braingram/stompy/docs/engine.md

Toyota land cruiser 2F engine (likely 1984:

https://en.wikipedia.org/wiki/Toyota_F_engine#2F

https://drive.google.com/drive/u/0/folders/0B5A2uNJ5ku1vfjJteHVhTnlReDZTcnRqa2hSbVFxMk9rVmVxb3V1NjZkLVpBU0FJSk9jbTg

Converted to propane

(quoted specs)
135 hp
200 ft-lb torque

stompy carb (throttle body and mixer) look a lot like this:
https://www.ebay.com/itm/Propane-LPG-Forklift-Carburetor-Carb-Mixer-CA125-20-M-CA125-20M/112722418038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

impco ca125 knock off?

http://propanedepot.ca/wp-content/uploads/2012/09/IMPCO-Model-CA125-Caburetor.pdf
