braingram/stompy/stompy/simulation/data/full_meshes/calf_lower.stl

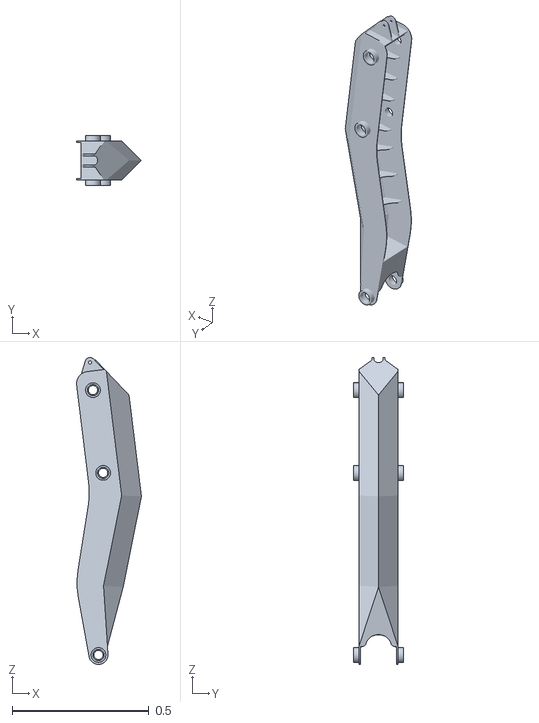
[picture p1: CAD file, 2019-08-05]
stompy/simulation/data/full_meshes/calf_lower.stl
0.237 x 0.181 x 1.12
