braingram/stompy/stompy/simulation/data/low_poly_meshes/hip.stl

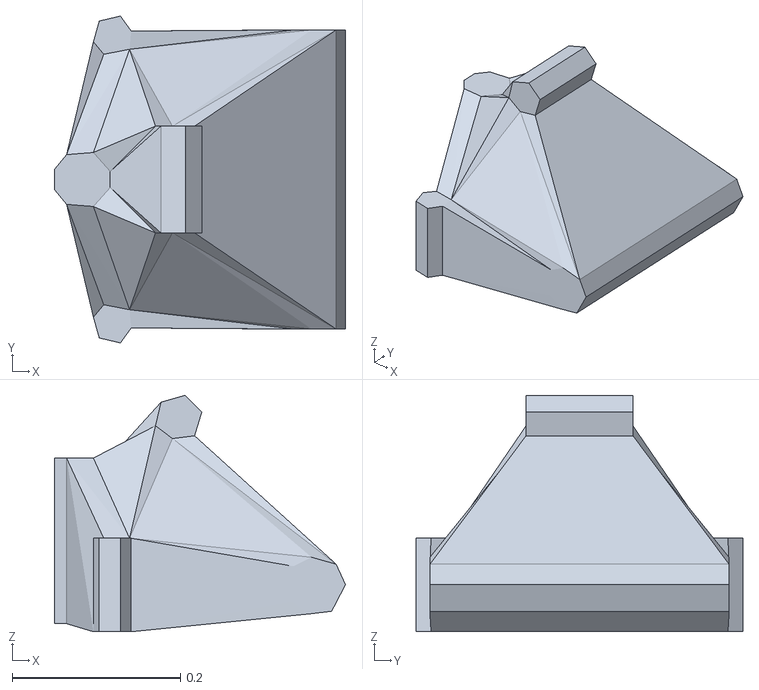
[picture p2: CAD file, 2019-08-05]
stompy/simulation/data/low_poly_meshes/hip.stl
0.346 x 0.389 x 0.281
