braingram/stompy/stompy/simulation/data/plane.obj

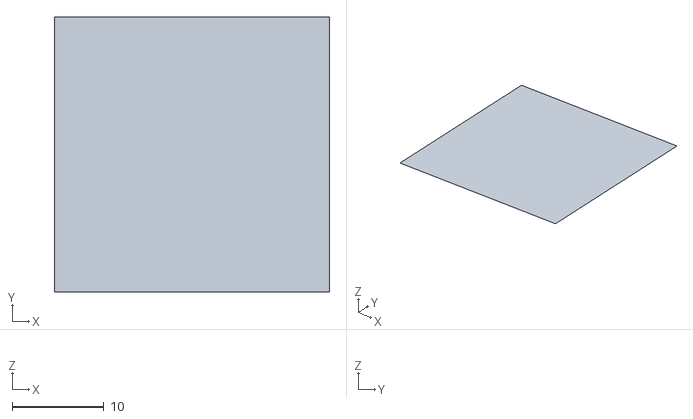
[picture p3: CAD file, 2019-08-05]
stompy/simulation/data/plane.obj
30.0 x 30.0 x 0
