braingram/stompy/stompy/simulation/data/full_meshes/thigh.stl

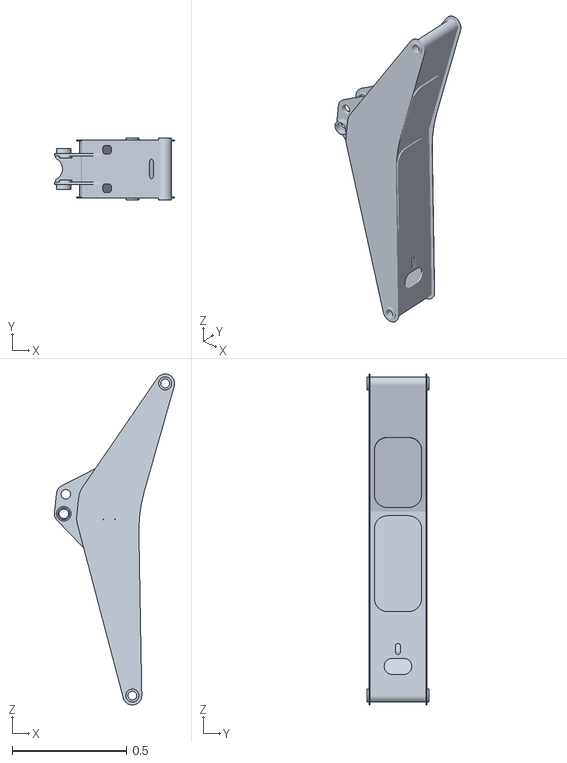
[picture p4: CAD file, 2019-08-05]
stompy/simulation/data/full_meshes/thigh.stl
0.525 x 0.273 x 1.45
