braingram/stompy/stompy/simulation/data/low_poly_meshes/calf_lower.stl

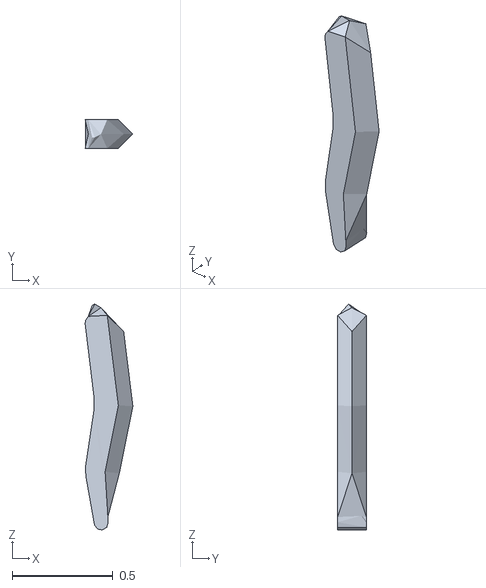
[picture p5: CAD file, 2019-08-05]
stompy/simulation/data/low_poly_meshes/calf_lower.stl
0.237 x 0.143 x 1.12
