braingram/stompy/stompy/simulation/data/full_meshes/hip.stl

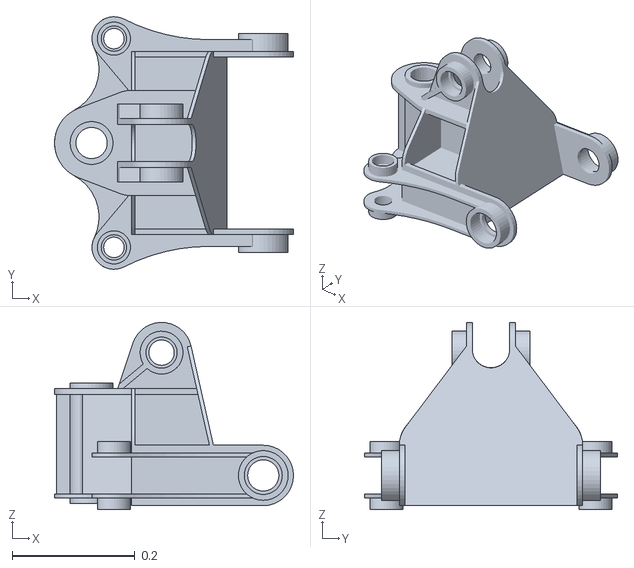
[picture p6: CAD file, 2019-08-05]
stompy/simulation/data/full_meshes/hip.stl
0.389 x 0.411 x 0.305
