braingram/stompy/stompy/simulation/data/low_poly_meshes/ankle.stl

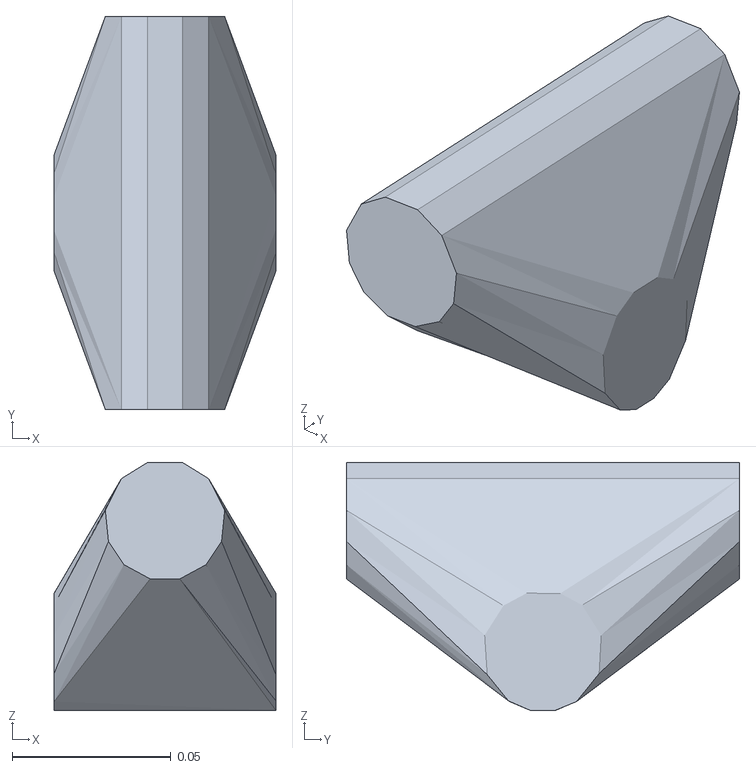
[picture p7: CAD file, 2019-08-05]
stompy/simulation/data/low_poly_meshes/ankle.stl
0.0698 x 0.124 x 0.0781
