braingram/stompy/stompy/simulation/data/full_meshes/calf_upper.stl

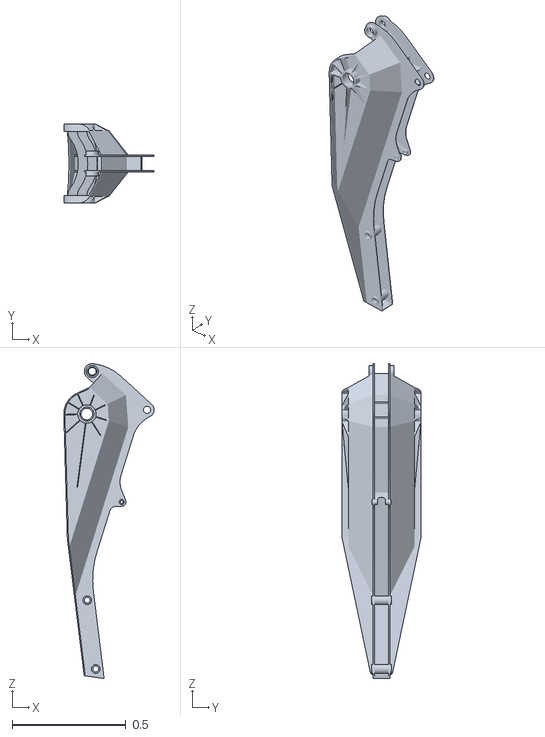
[picture p8: CAD file, 2019-08-05]
stompy/simulation/data/full_meshes/calf_upper.stl
0.398 x 0.346 x 1.39
