braingram/stompy/stompy/simulation/data/low_poly_meshes/calf_upper.stl

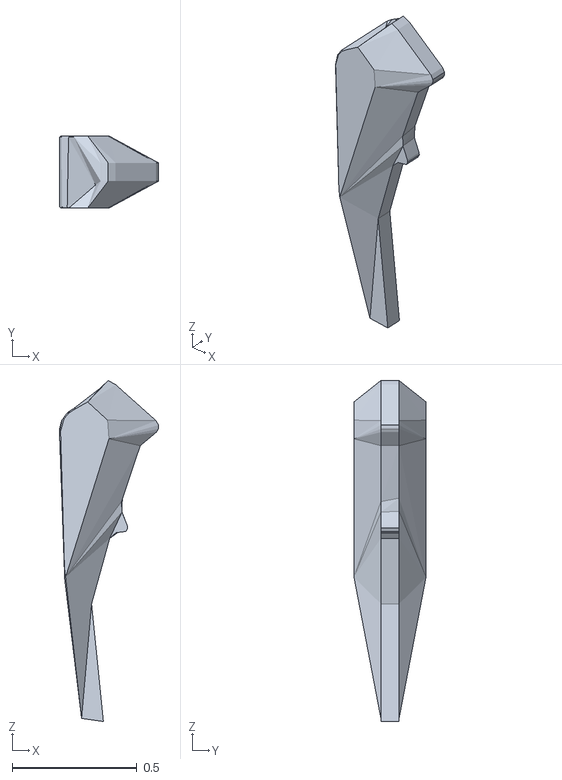
[picture p9: CAD file, 2019-08-05]
stompy/simulation/data/low_poly_meshes/calf_upper.stl
0.397 x 0.289 x 1.37
