braingram/stompy/stompy/simulation/data/full_meshes/body.stl

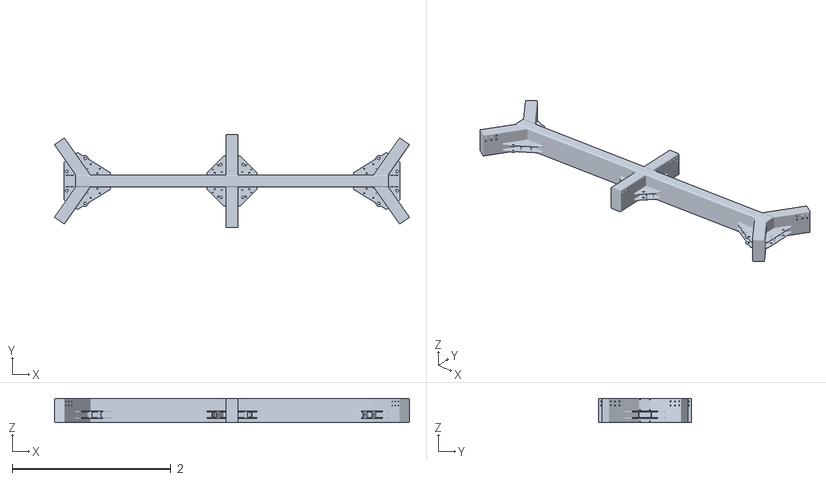
[picture p10: CAD file, 2018-02-03]
stompy/simulation/data/full_meshes/body.stl
4.48 x 1.17 x 0.305
