braingram/stompy/stompy/simulation/data/low_poly_meshes/foot.stl

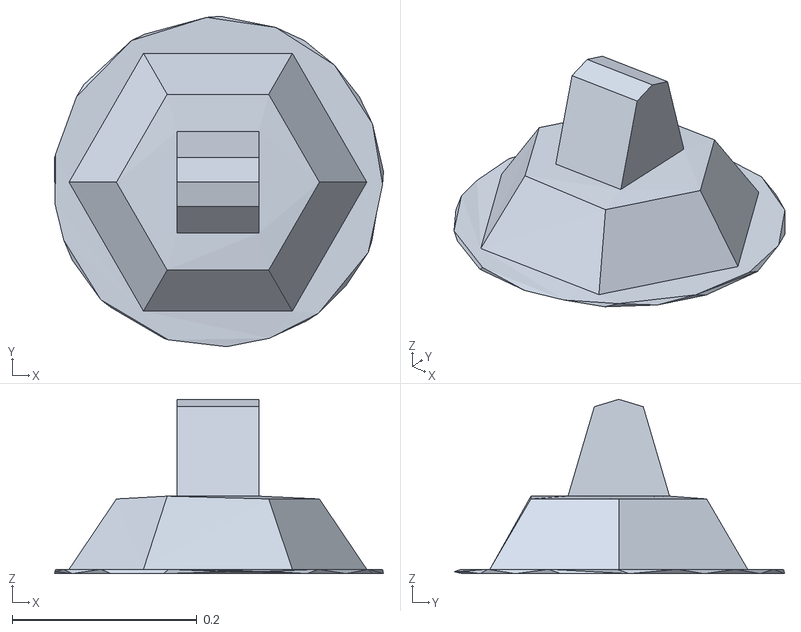
[picture p11: CAD file, 2019-08-05]
stompy/simulation/data/low_poly_meshes/foot.stl
0.356 x 0.358 x 0.189
