braingram/stompy/stompy/simulation/data/full_meshes/calf_link.stl

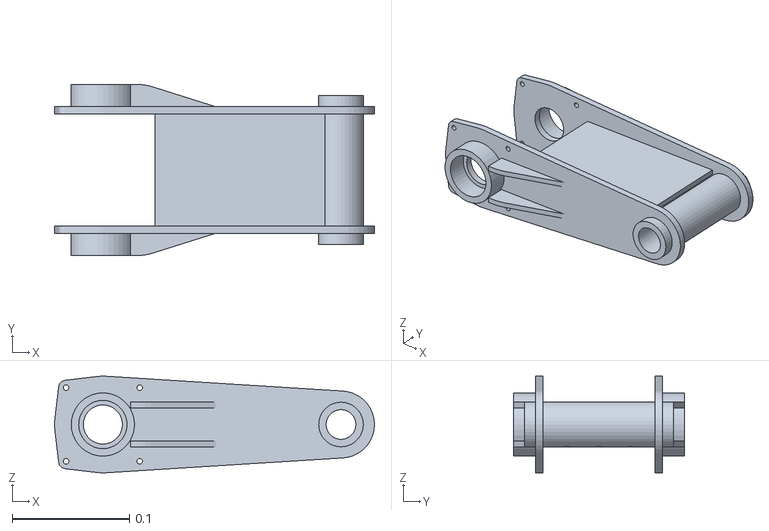
[picture p12: CAD file, 2018-02-03]
stompy/simulation/data/full_meshes/calf_link.stl
0.273 x 0.146 x 0.0825
