braingram/stompy/stompy/simulation/data/low_poly_meshes/body.stl

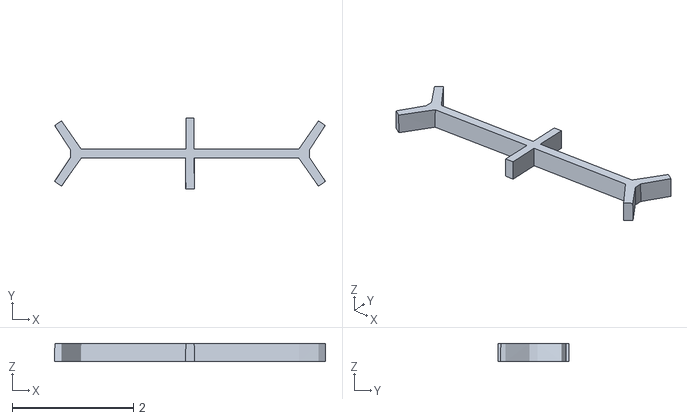
[picture p13: CAD file, 2019-08-05]
stompy/simulation/data/low_poly_meshes/body.stl
4.47 x 1.17 x 0.305
