braingram/stompy/stompy/simulation/data/full_meshes/ankle.stl

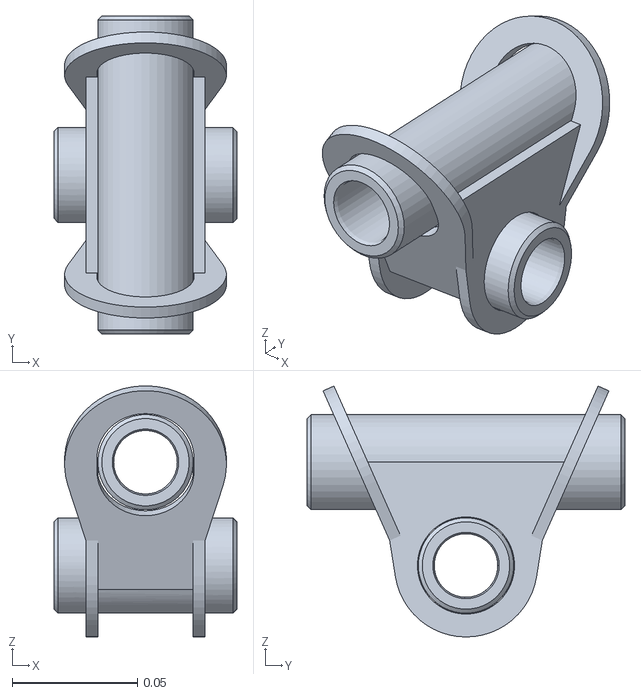
[picture p14: CAD file, 2018-02-03]
stompy/simulation/data/full_meshes/ankle.stl
0.073 x 0.127 x 0.1
