braingram/stompy/stompy/simulation/data/low_poly_meshes/calf_link.stl

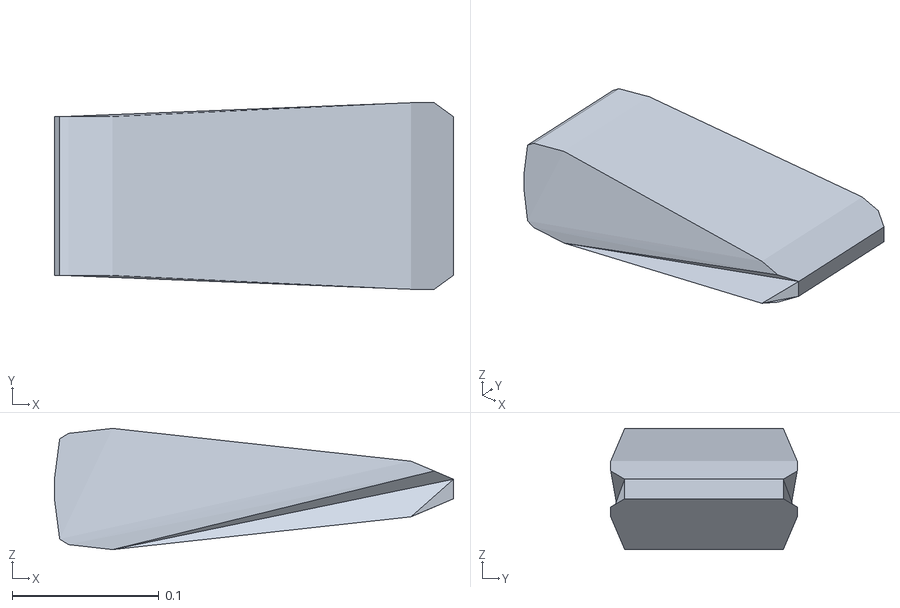
[picture p15: CAD file, 2019-08-05]
stompy/simulation/data/low_poly_meshes/calf_link.stl
0.272 x 0.127 x 0.0825
