braingram/stompy/stompy/simulation/data/full_meshes/foot.stl

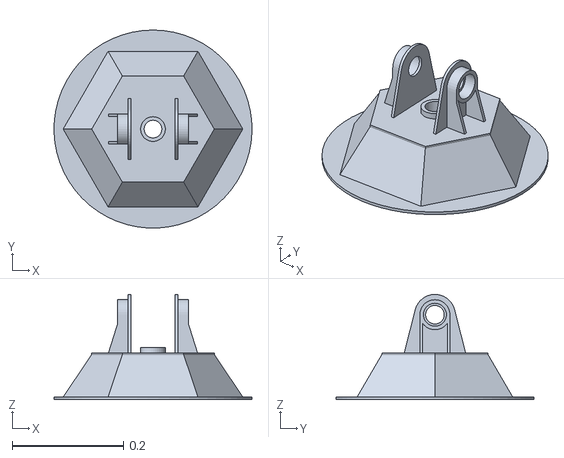
[picture p16: CAD file, 2018-02-03]
stompy/simulation/data/full_meshes/foot.stl
0.355 x 0.355 x 0.189
