braingram/stompy/stompy/simulation/data/low_poly_meshes/thigh.stl

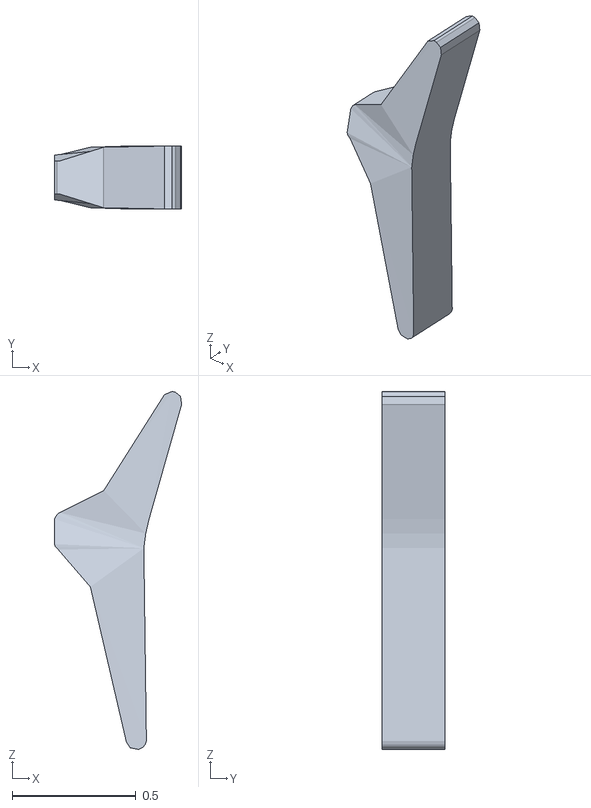
[picture p17: CAD file, 2019-08-05]
stompy/simulation/data/low_poly_meshes/thigh.stl
0.514 x 0.254 x 1.45
