braingram/stompy/(threads)

Thread 6 (2016-08-13):

Update sensors.joints.update_joints to allow for multiple joint publishers

braingram, 2016-08-13:
Each leg node will be publishing a different set of joints. These will come into the head node with different message headers. Keeping track of the arrival times could be useful.

Closed 2016-08-14.

Thread 7 (2016-08-13):

kinematics.leg.inverse deal with -x and x close to 0 errors

braingram, 2016-08-13:
