braingram/stompy/docs/cad_drawings/body_and_hips.pdf

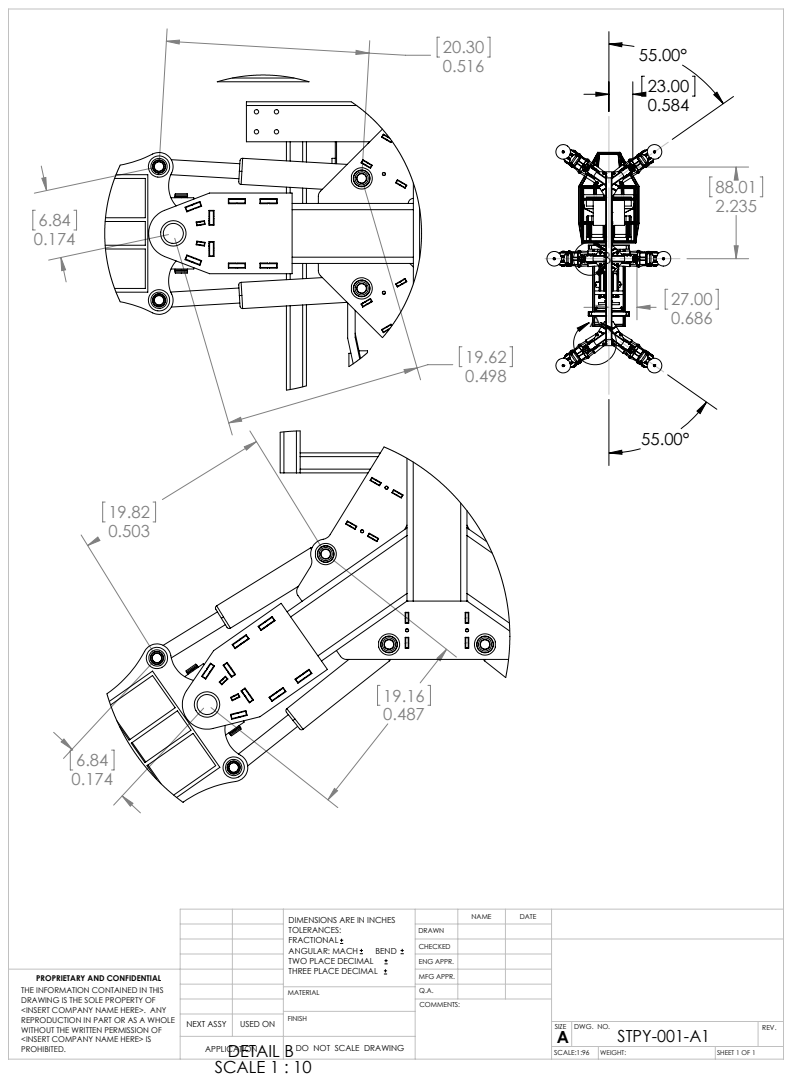
[picture p18: page 1]
SCALE 1 : 10

TOLERANCES: FRACTIONAL ANGULAR: MACH BEND TWO PLACE DECIMAL THREE PLACE DECIMAL | | NAME | DATE DIMENSIONS ARE IN INCHES

DRAWN
CHECKED
ENG APPR.

PROPRIETARY AND CONFIDENTIAL THE INFORMATION CONTAINED IN THIS DRAWING IS THE SOLE PROPERTY OF <INSERT COMPANY NAME HERE>. ANY REPRODUCTION IN PART OR AS A WHOLE WITHOUT THE WRITTEN PERMISSION OF <INSERT COMPANY NAME HERE> IS PROHIBITED. | | | MFG APPR.

MATERIAL | Q.A.

NEXT ASSY | USED ON | FINISH
DETAIL B APPLICATION | | DO NOT SCALE DRAWING

SIZE A | DWG. NO. STPY-001-A1 | REV.

SCALE:1:96 | WEIGHT: | SHEET 1 OF 1
