braingram/stompy/docs/cad_drawings/leg.pdf

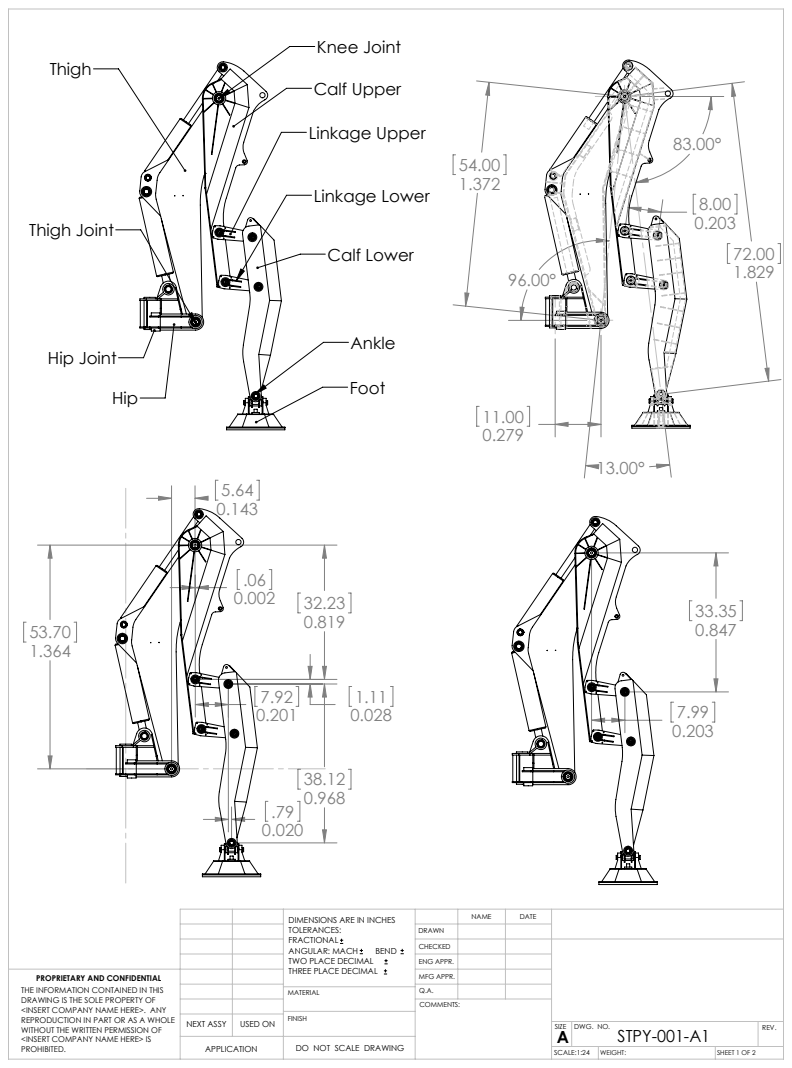
[picture p19: page 1]
Knee Joint; Calf Upper; Linkage Upper; Linkage Lower; Calf Lower; Thigh Joint; Hip Joint

TOLERANCES: FRACTIONAL ANGULAR: MACH BEND TWO PLACE DECIMAL THREE PLACE DECIMAL | | NAME | DATE DIMENSIONS ARE IN INCHES

DRAWN
CHECKED
ENG APPR.

PROPRIETARY AND CONFIDENTIAL THE INFORMATION CONTAINED IN THIS DRAWING IS THE SOLE PROPERTY OF <INSERT COMPANY NAME HERE>. ANY REPRODUCTION IN PART OR AS A WHOLE WITHOUT THE WRITTEN PERMISSION OF <INSERT COMPANY NAME HERE> IS PROHIBITED. | | | MFG APPR.

MATERIAL | Q.A.

NEXT ASSY | USED ON | FINISH

SIZE A | DWG. NO. STPY-001-A1 | REV.

APPLICATION | | DO NOT SCALE DRAWING

SCALE:1:24 | WEIGHT: | SHEET 1 OF 2

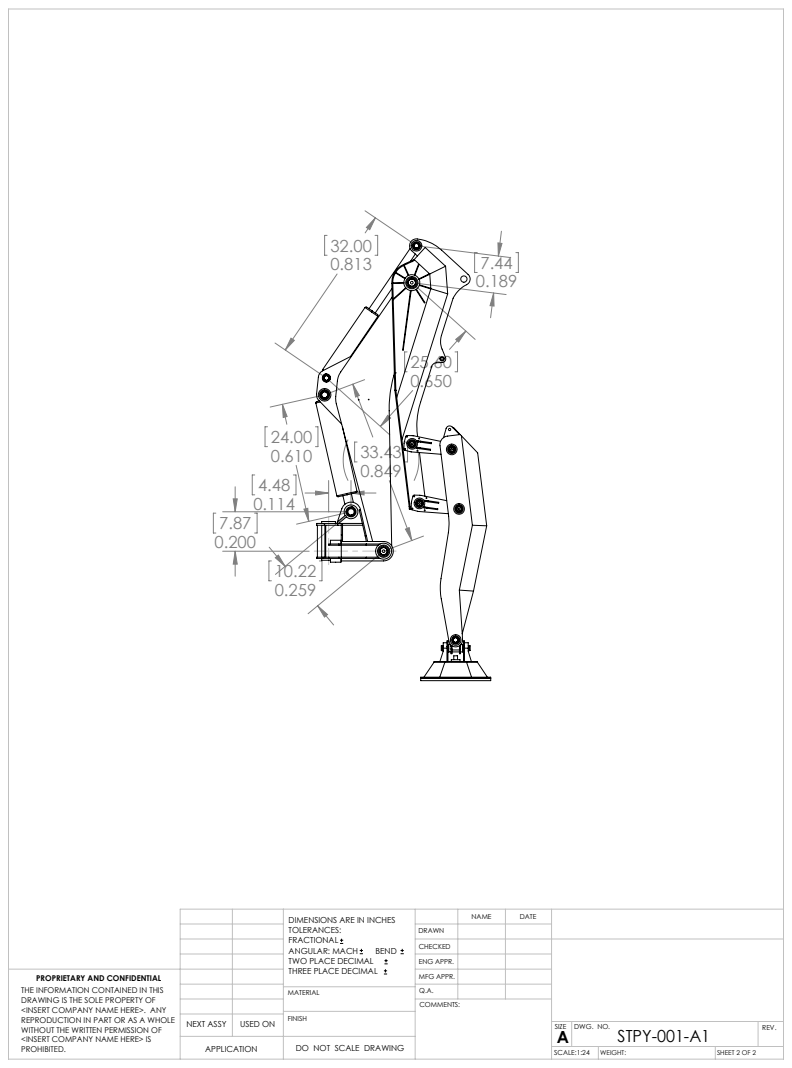
[picture p20: page 2]
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

DRAWN
CHECKED
ENG APPR.

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

MATERIAL | Q.A.

NEXT ASSY | USED ON | FINISH

SIZE A | DWG. NO. STPY-001-A1 | REV.

APPLICATION | | DO NOT SCALE DRAWING

SCALE:1:24 | WEIGHT: | SHEET 2 OF 2
