braingram/stompy/electronics/leg_thing/180513v1/leg_thing_pcb.pdf

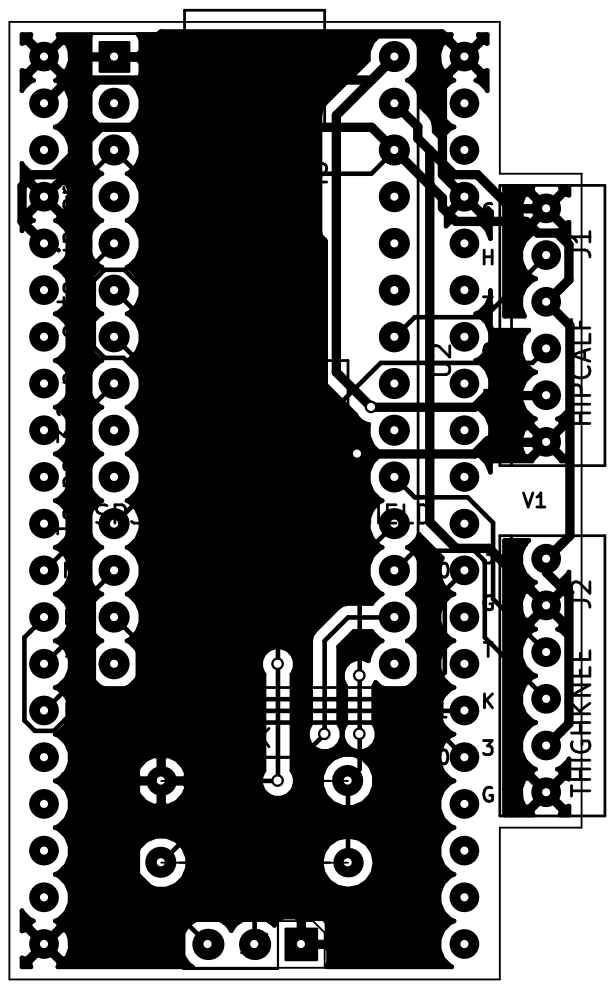
[picture p21: page 1]
