braingram/stompy/electronics/leg_thing/180513v1/leg_thing_sch.pdf

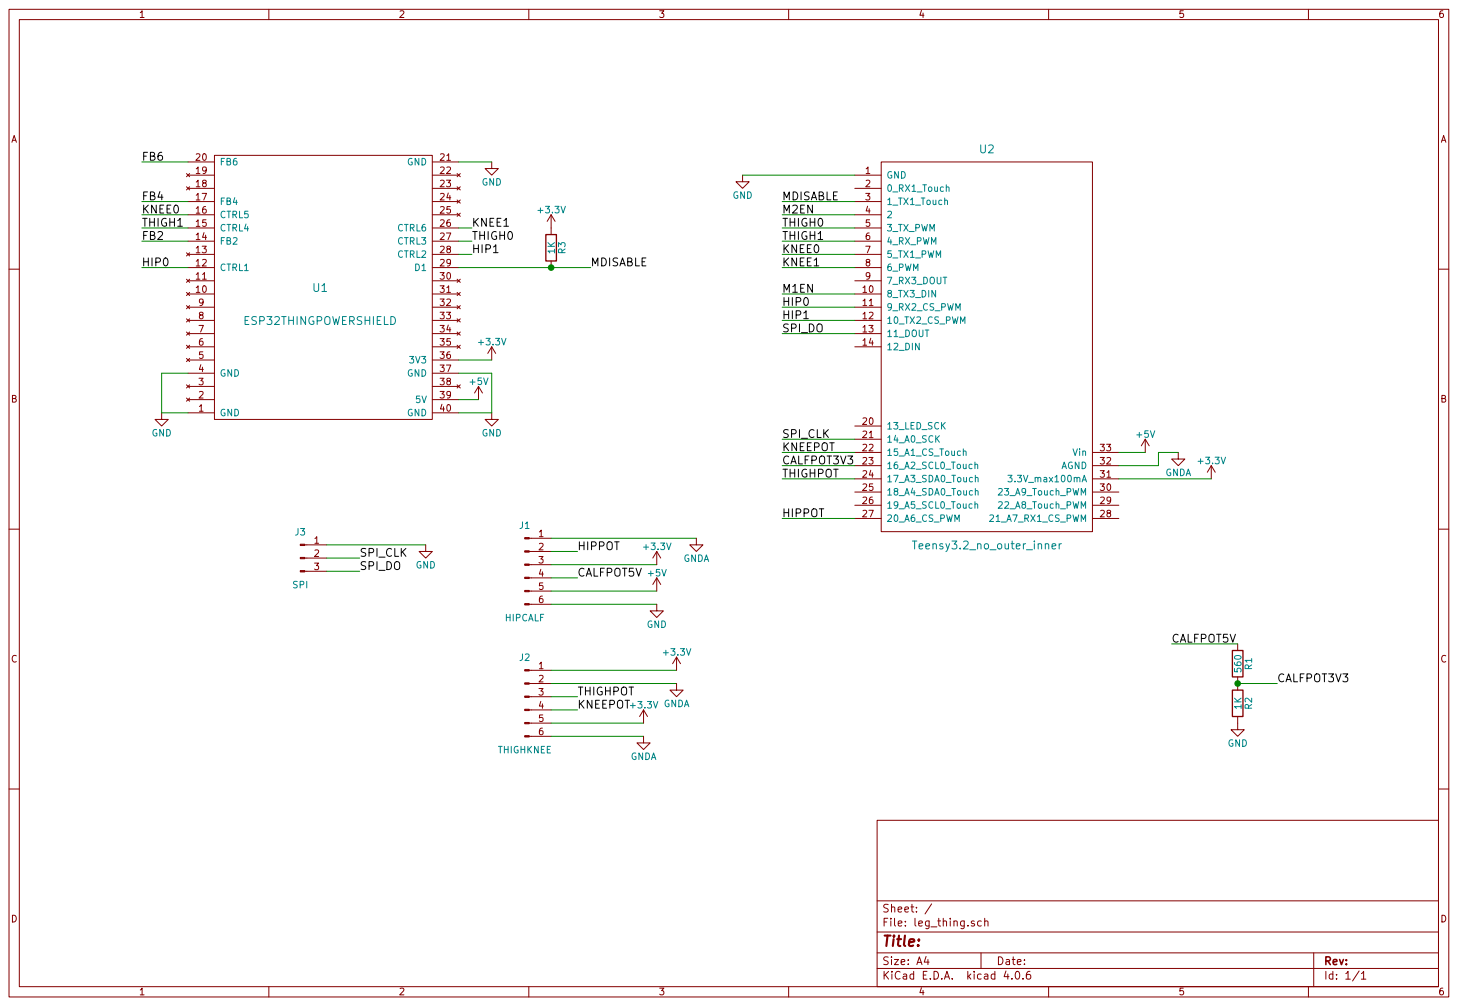
[picture p22: page 1]

THIGH0 | 3_TX_PWM 5

4_RX_PWM 6
