braingram/stompy/electronics/leg_thing/180513v1/leg_thing.kicad_pcb

## KiCad design electronics/leg_thing/180513v1/leg_thing.kicad_pcb (2018-05-27)

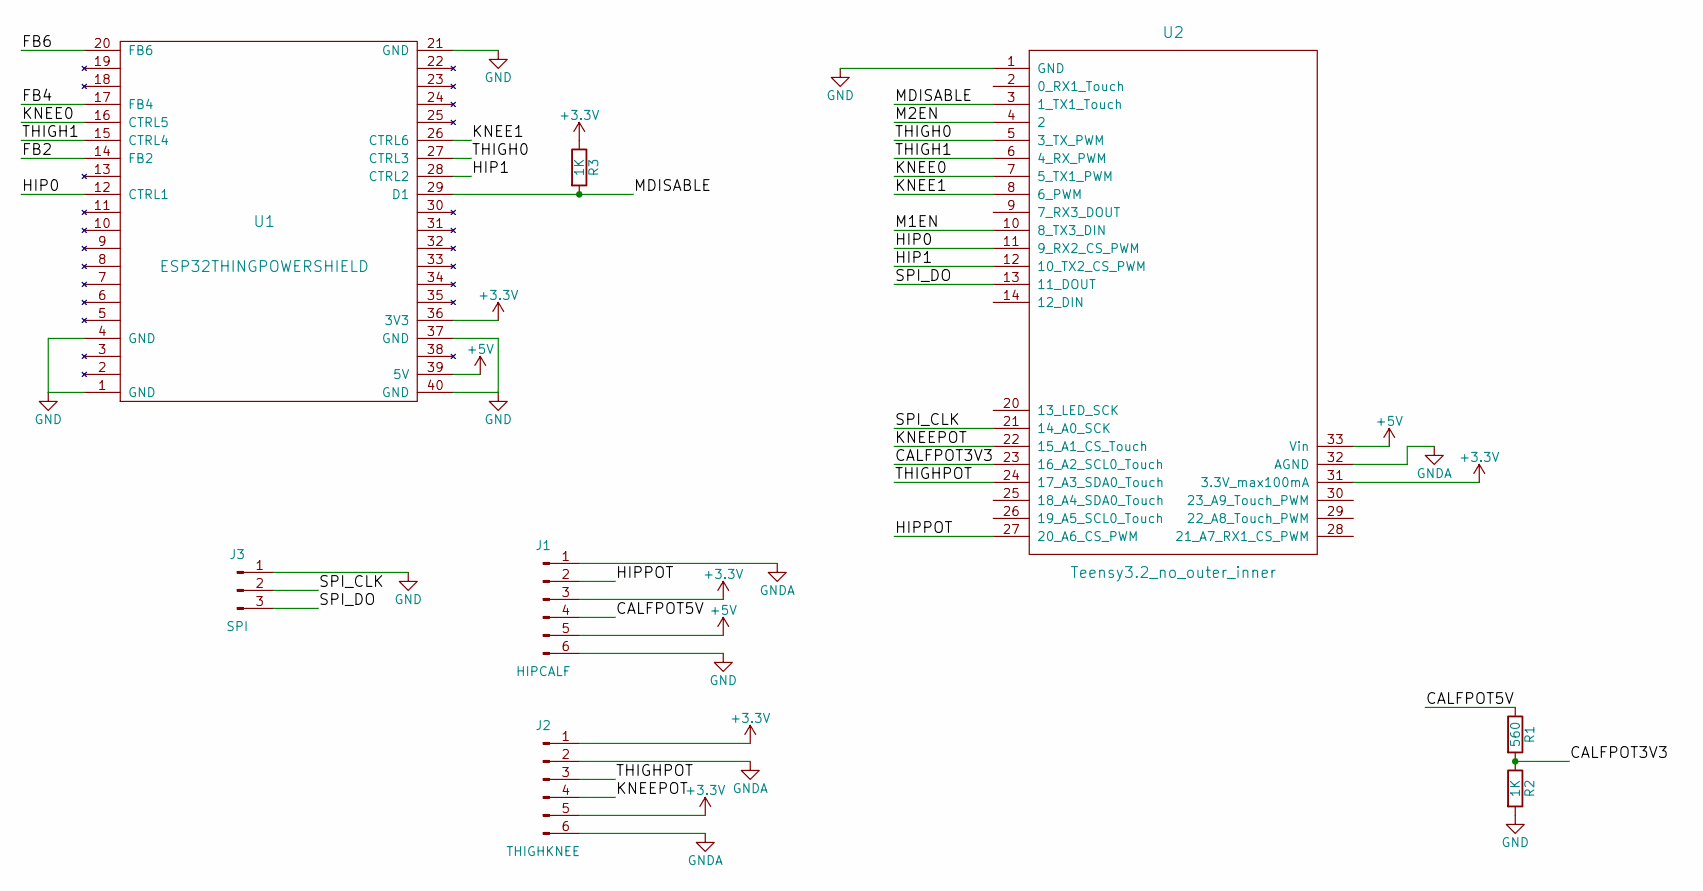
[picture p23: schematic leg_thing.sch]

Parts:
J1: HIPCALF; MOLEX6PIN
J2: THIGHKNEE; MOLEX6PIN
J3: SPI; Pin_Header_Straight_1x03_Pitch2.54mm
R1: 560; R_Axial_DIN0207_L6.3mm_D2.5mm_P10.16mm_Horizontal
R2: 1K; R_Axial_DIN0207_L6.3mm_D2.5mm_P10.16mm_Horizontal
R3: 1K; R_1206_HandSoldering
U1: ESP32THINGPOWERSHIELD
U2: Teensy3.2_no_outer_inner; Teensy30_31_32_LC_NO_INNER_OUTER

Connections:
+3V3: J1.3, J2.1, J2.5, R3.1, U1.36 (3V3), U2.31 (3.3V_max100mA)
+5V: J1.5, U1.39 (5V), U2.33 (Vin)
/CALFPOT3V3: R1.2, R2.1, U2.23 (16_A2_SCL0_Touch)
/CALFPOT5V: J1.4, R1.1
/FB2: U1.14 (FB2)
/FB4: U1.17 (FB4)
/FB6: U1.20 (FB6)
/HIP0: U1.12 (CTRL1), U2.11 (9_RX2_CS_PWM)
/HIP1: U1.28 (CTRL2), U2.12 (10_TX2_CS_PWM)
/HIPPOT: J1.2, U2.27 (20_A6_CS_PWM)
/KNEE0: U1.16 (CTRL5), U2.7 (5_TX1_PWM)
/KNEE1: U1.26 (CTRL6), U2.8 (6_PWM)
/KNEEPOT: J2.4, U2.22 (15_A1_CS_Touch)
/M1EN: U2.10 (8_TX3_DIN)
/M2EN: U2.4 (2)
/MDISABLE: R3.2, U1.29 (D1), U2.3 (1_TX1_Touch)
/SPI_CLK: J3.2, U2.21 (14_A0_SCK)
/SPI_DO: J3.3, U2.13 (11_DOUT)
/THIGH0: U1.27 (CTRL3), U2.5 (3_TX_PWM)
/THIGH1: U1.15 (CTRL4), U2.6 (4_RX_PWM)
/THIGHPOT: J2.3, U2.24 (17_A3_SDA0_Touch)
GND: J1.6, J3.1, R2.2, U1.1 (GND), U1.4 (GND), U1.21 (GND), U1.37 (GND), U1.40 (GND), U2.1 (GND)
GNDA: J1.1, J2.2, J2.6, U2.32 (AGND)

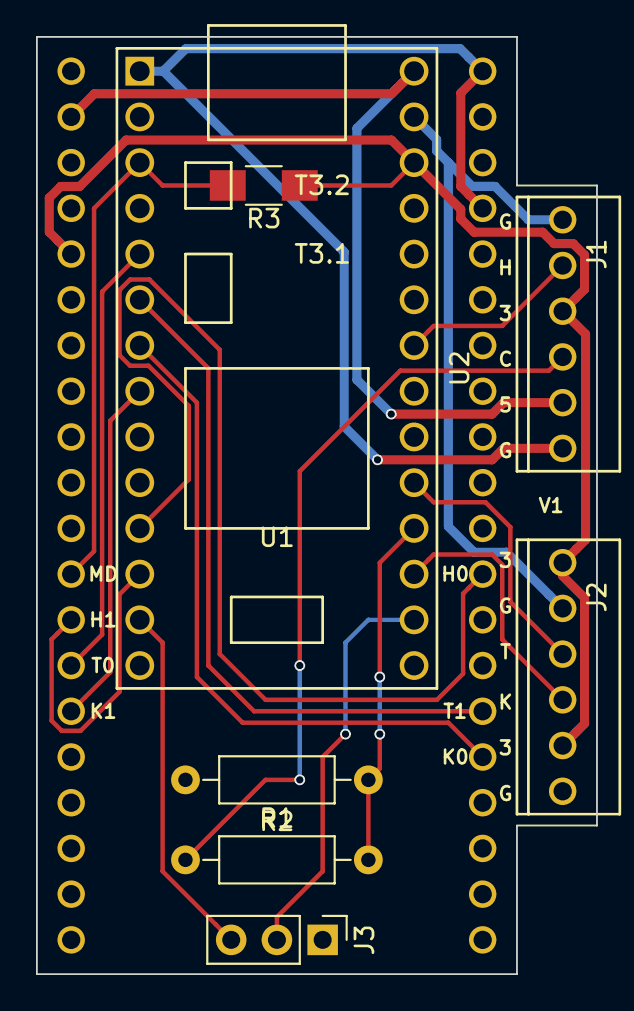
[picture p24: board leg_thing.kicad_pcb from above]

Board: 2 copper layers, 31.1 x 52.1 mm, 8 parts (0 on the bottom side), 18 nets.
