braingram/stompy/stompy/leg/teensy.py

#!/usr/bin/env python

#import glob
import logging
#import subprocess
import sys
import time
import traceback

import numpy
import serial

import pycomando

from .. import consts
from .. import calibration
#from .. import geometry
from .. import kinematics
from .. import log
from . import plans
from .. import signaler
from .. import simulation
from .. import transforms
from .. import utils


logger = logging.getLogger(__name__)

cmds = {
    0: 'heartbeat',
    1: 'estop(byte)=byte',  # 0 = off, 1 = soft, 2 = hard
    2: 'pwm(float,float,float)=float,float,float',  # hip thigh knee
    3: 'plan(byte,byte,float,float,float,float,float,float,float,'
       'float,float,float,float,float,float,float,float,float,float)',
    4: 'enable_pid(bool)=bool',
    5: 'pid_config(byte,float,float,float,float,float)='
       'byte,float,float,float,float,float',
    6: 'leg_number(byte)=byte',
    7: 'pwm_limits(byte,int32,int32,int32,int32)=byte,int32,int32,int32,int32',
    8: 'adc_limits(byte,float,float)=byte,float,float',
    9: 'calf_scale(float,float)=float,float',
    10: 'report_time(uint32)=uint32',
    11: 'pid_seed_time=float',
    12: 'reset_pids(bool)',  # i_only
    13: 'dither(uint32,int)=uint32,int',
    14: 'following_error_threshold(byte,float)=byte,float',
    16: 'set_geometry(byte,byte,float)',

    21: 'report_adc(bool)=uint32,uint32,uint32,uint32',
    22: 'report_pid(bool)='
        'float,float,float,float,float,float,float,float,float',
    23: 'report_pwm(bool)=int32,int32,int32',
    24: 'report_xyz(bool)=float,float,float',
    25: 'report_angles(bool)=float,float,float,float,bool',
    26: 'report_loop_time(bool)=uint32',
}


class LegController(signaler.Signaler):
    def __init__(self, leg_number):
        super(LegController, self).__init__()
        self.leg_number = leg_number
        #log.info({'leg_number': self.leg_number})
        logger.debug("leg number = %s" % (self.leg_number, ))

        self.leg_name = consts.LEG_NAME_BY_NUMBER[self.leg_number]
        self.geometry = kinematics.leg.LegGeometry(self.leg_number)
        #log.info({'leg_name': self.leg_name})

        self.log = log.make_logger(self.leg_name)

        self.estop = None
        self.plan = None

        self.adc = {}
        self.angles = {}
        self.xyz = {}
        self.pid = {}
        self.pwm = {}

    def set_estop(self, value):
        if value != self.estop:
            self.estop = value
            self.log.info({'estop': value})
            self.trigger('estop', value)

    def enable_pid(self, value):
        self.log.debug({'enable_pid': value})

    def update(self):
        pass

    def _resolve_plan(self, *args, **kwargs):
        if len(args) == 0 and len(kwargs) == 0:
            plan = plans.stop()
        if len(args) == 1 and isinstance(args[0], plans.Plan):
            plan = args[0]
        else:
            plan = plans.Plan(*args, **kwargs)
        return plan
        #return plan.packed(self.leg_number)

    def set_pwm(self, hip, thigh, knee):
        self.log.info({'set_pwm': {
            'hip': hip, 'thigh': thigh, 'knee': knee}})
        self.trigger('set_pwm', (hip, thigh, knee))

    def send_plan(self, *args, **kwargs):
        self.plan = self._resolve_plan(*args, **kwargs)
        self._packed_plan = self.plan.packed(self.leg_number)
        self.log.info({'plan': self._packed_plan})
        self.trigger('plan', self._packed_plan)

    def stop(self):
        """Send stop plan"""
        self.send_plan(plans.stop())

    def pid_joint_config(self, joint_index):
        return {}

    def configure(self, settings):
        """takes a list of commands of form (name, (args))"""
        return


class FakeTeensy(LegController):
    def __init__(self, leg_number):
        super(FakeTeensy, self).__init__(leg_number)
        self._sim = simulation.get()
        self._sim.register_leg(self)
        self._ln = "".join(s[0].lower() for s in self.leg_name.split('-'))
        #self._position_noise = 0.05  # in inches
        self._position_noise = 0.0  # in inches
        #self._loaded_height = -40
        self._calf_load = 0.
        self.on('plan', self._new_plan)

        self.estop = True
        self.pwm = {'hip': 0, 'thigh': 0, 'knee': 0, 'time': time.time()}
        self.pid = {
            'time': time.time(),
            'output': {'hip': 0, 'thigh': 0, 'knee': 0},
            'set_point': {'hip': 0, 'thigh': 0, 'knee': 0},
            'error': {'hip': 0, 'thigh': 0, 'knee': 0},
        }
        self.adc = {
            'time': time.time(), 'hip': 0, 'thigh': 0, 'knee': 0, 'calf': 0}
        # approximate dolly sitting position?
        #self.angles = {
        #    'time': time.time(),
        #    'hip': 0, 'thigh': 0.312, 'knee': -0.904, 'calf': 0}
        # approximate short stand
        #states = self._sim.get_joint_states()[self._ln]
        #self.angles = {
        #    'time': time.time(),
        #    'hip': states['hip'],
        #    'thigh': states['thigh'], 'knee': states['knee'], 'calf': 0}
        self.angles = {
            'time': time.time(),
            'hip': 0, 'thigh': 0.912, 'knee': -1.04, 'calf': 0}
        ja = {self._ln: {k: self.angles[k]for k in ('hip', 'thigh', 'knee')}}
        #self._sim.update()
        self._sim.set_joint_angles(ja)

        x, y, z = list(self.geometry.angles_to_points(
            self.angles['hip'], self.angles['thigh'], self.angles['knee']))[-1]
        self.xyz = {
            'time': time.time(), 'x': x, 'y': y, 'z': z}
        self._last_update = time.time()
        self._plan = None
        self._ddt = 0.
        if consts.PLAN_TICK is None:
            consts.PLAN_TICK = 0.025

    def _new_plan(self, pp):
        # if body frame, plan packing converted to leg
        if pp[0] == consts.PLAN_STOP_MODE:
            m, f, s = pp
            p = plans.Plan(m, f, speed=s)
        elif pp[0] in (consts.PLAN_TARGET_MODE, consts.PLAN_VELOCITY_MODE):
            m, f, lx, ly, lz, s = pp
            p = plans.Plan(
                m, f, linear=(lx, ly, lz), speed=s)
        elif pp[0] == consts.PLAN_ARC_MODE:
            m, f, lx, ly, lz, ax, ay, az, s = pp
            p = plans.Plan(
                m, f, linear=(lx, ly, lz), angular=(ax, ay, az), speed=s)
        elif pp[0] == consts.PLAN_MATRIX_MODE:
            m = pp[0]
            f = pp[1]
            s = pp[-1]
            matrix = numpy.matrix(numpy.identity(4))
            matrix[:3, :] = numpy.matrix(numpy.reshape(pp[2:-1], (3, 4)))
            p = plans.Plan(m, f, matrix=matrix, speed=s)
        if m != consts.PLAN_STOP_MODE:
            if f != consts.PLAN_LEG_FRAME:
                raise NotImplementedError('fake following of non-leg plans')
        self._plan = p

    def _follow_plan(self, t, dt):
        self.xyz['time'] = t
        self.angles['time'] = t
        if self.estop or self._plan is None:
            return
        xyz = [self.xyz['x'], self.xyz['y'], self.xyz['z']]
        if self._plan.mode == consts.PLAN_MATRIX_MODE:
            # if matrix mode, split up dt, only pass in full multiple of TICK
            self._ddt += dt
            idt, rdt = divmod(self._ddt, consts.PLAN_TICK)
            if idt > 0:
                xyz = plans.follow_plan(xyz, self._plan, idt * consts.PLAN_TICK)
                self._ddt = rdt
        else:
            xyz = plans.follow_plan(xyz, self._plan, dt)
        self.xyz['x'] = xyz[0]
        self.xyz['y'] = xyz[1]
        self.xyz['z'] = xyz[2]

        # add noise
        if self._position_noise != 0.:
            xyzn = (numpy.random.rand(3) - 0.5) * 2. * self._position_noise
            self.xyz['x'] += xyzn[0]
            self.xyz['y'] += xyzn[1]
            self.xyz['z'] += xyzn[2]
        hip, thigh, knee = self.geometry.point_to_angles(
            self.xyz['x'], self.xyz['y'], self.xyz['z'])
        # check if angles are in limits, if not, stop
        in_limits = True
        if hip < self.geometry.hip.min_angle:
            hip = self.geometry.hip.min_angle
            in_limits = False
        if hip > self.geometry.hip.max_angle:
            hip = self.geometry.hip.max_angle
            in_limits = False
        if thigh < self.geometry.thigh.min_angle:
            thigh = self.geometry.thigh.min_angle
            in_limits = False
        if thigh > self.geometry.thigh.max_angle:
            thigh = self.geometry.thigh.max_angle
            in_limits = False
        if knee < self.geometry.knee.min_angle:
            knee = self.geometry.knee.min_angle
            in_limits = False
        if knee > self.geometry.knee.max_angle:
            knee = self.geometry.knee.max_angle
            in_limits = False
        if not in_limits:
            x, y, z = list(
                self.geometry.angles_to_points(hip, thigh, knee))[-1]
            self.xyz['x'] = x
            self.xyz['y'] = y
            self.xyz['z'] = z
            # raise estop
            self.set_estop(consts.ESTOP_HOLD)
        # fake calf loading
        #zl = max(
        #    self._loaded_height - 5, min(
        #        self._loaded_height, self.xyz['z']))
        #calf = -(zl - self._loaded_height) * 400
        # get calf load
        self._calf_load = (
            -(self._sim.get_joint_states()[self._ln]['calf'] * 0.224809))
        #print(self._ln, self._calf_load)
        self.angles.update({
            'hip': hip, 'thigh': thigh, 'knee': knee, 'calf': self._calf_load})
        #print(self.leg_number, self._plan.mode, self.angles, self.xyz)
        # get angles from x, y, z
        #h, t, k = 0., 0., 0.
        #x, y, z = list(self.geometry.angles_to_points(h, t, k))
        #self.xyz.update({'x': x, 'y': y, 'z': z})
        #self.angles.update({'hip': h, 'thigh': t, 'knee': k})

    def update(self):
        t = time.time()
        dt = t - self._last_update
        if dt > 0.1:
            # follow plan, update angles
            self._follow_plan(t, dt)
            self.angles['time'] = t
            self.adc['time'] = t
            self.xyz.update({'time': t})

            # generate events:
            self.pwm['time'] = t
            self.pid['time'] = t
            self.trigger('adc', self.adc)
            self.trigger('pwm', self.pwm)
            self.trigger('pid', self.pid)
            self.trigger('angles', self.angles)
            self.trigger('xyz', self.xyz)
            self._last_update = t
            
            # move joints
            ja = {self._ln: {k: self.angles[k]for k in ('hip', 'thigh', 'knee')}}
            self._sim.update()
            self._sim.set_joint_angles(ja)


def open_port(port, timeout=5.0):
    t0 = time.monotonic()
    while time.monotonic() - t0 < timeout:
        try:
            s = serial.Serial(port, 9600)
            return s
        except serial.serialutil.SerialException:
            time.sleep(0.01)
    raise IOError("Failed to connect to teensy on port: %s" % port)


class Teensy(LegController):
    def __init__(self, port):
        print("Connecting to teensy on port: %s" % port)
        self.port = port
        #self._serial = serial.Serial(self.port, 9600)
        self._serial = open_port(self.port)
        # set rising edge of RTS to reset comando
        self._serial.setRTS(0)
        self._serial.flushInput()
        self._serial.flushOutput()
        self._serial.setRTS(1)
        #time.sleep(0.5)
        # start up comando
        self.com = pycomando.Comando(self._serial)
        self.cmd = pycomando.protocols.command.CommandProtocol()
        self._text = pycomando.protocols.text.TextProtocol()

        self.com.register_protocol(0, self.cmd)
        # used for callbacks
        self.mgr = pycomando.protocols.command.EventManager(self.cmd, cmds)
        # easier for calling
        # self.ns = self.mgr.build_namespace()
        # get leg number
        logger.debug("%s Get leg number" % port)
        ln = self.mgr.blocking_trigger('leg_number')[0].value
        print("Connected to leg %s on port %s" % (ln, port))
        super(Teensy, self).__init__(ln)

        def print_text(txt, leg_number=ln):
            print("DEBUG[%s]:%s" % (leg_number, txt))

        self._text.register_callback(print_text)
        self.com.register_protocol(1, self._text)

        # load calibration setup
        for v in calibration.setup.get(self.leg_number, []):
            self.log.debug({'calibration': v})
            print("calibration: %s" % v)
            f, args = v
            logger.debug("Calibration: %s, %s" % (f, args))
            self.mgr.trigger(f, *args)
        # write out leg geometry
        for (ji, jn) in enumerate(['hip', 'thigh', 'knee']):
            j = getattr(self.geometry, jn)
            for attr in consts.GEOM_INDEX_BY_NAME:
                code = consts.GEOM_INDEX_BY_NAME[attr]
                value = getattr(j, attr)
                self.log.debug({'set_geometry': (ji, code, value)})
                self.mgr.trigger('set_geometry', ji, code, value)

        self.mgr.on('estop', self.on_estop)
        self.loop_time_stats = utils.StatsMonitor()

        # disable leg
        self.set_estop(consts.ESTOP_DEFAULT)

        # verify seed time against python code
        seed_time = self.mgr.blocking_trigger('pid_seed_time')[0].value
        # set plan tick on first leg connected
        if consts.PLAN_TICK is None:
            # round to nearest ms
            consts.PLAN_TICK = numpy.round(seed_time * 1000.) / 1000.
        if abs(seed_time - consts.PLAN_TICK) > 1E-9:
            raise ValueError(
                "PID seed time [%s] for leg %s does not match python %s" %
                (seed_time, self.leg_number, consts.PLAN_TICK))

        # send first heartbeat
        self.send_heartbeat()

        self.mgr.on('report_xyz', self.on_report_xyz)
        self.mgr.on('report_angles', self.on_report_angles)
        self.mgr.on('report_pid', self.on_report_pid)
        self.mgr.on('report_pwm', self.on_report_pwm)
        self.mgr.on('report_adc', self.on_report_adc)
        self.mgr.on('report_loop_time', self.on_report_loop_time)

        self.calibrators = {
            'calf': calibration.CalfCalibrator(),
            # hip, thigh, knee
        }

        # request current calibration values
        self.calibrators['calf'].attach_manager(self.mgr)

    def pid_joint_config(self, joint_index):
        if joint_index in consts.JOINT_INDEX_BY_NAME:
            joint_index = consts.JOINT_INDEX_BY_NAME[joint_index]
        if joint_index not in consts.JOINT_NAME_BY_INDEX:
            return {}
        joint_config = {}
        # get pid_config
        #print("Get pid config: %s" % joint_index)
        r = self.mgr.blocking_trigger('pid_config', joint_index)
        joint_config['pid'] = {
            'p': r[1].value,
            'i': r[2].value,
            'd': r[3].value,
            'min': r[4].value,
            'max': r[5].value,
        }
        # following error threshold
        r = self.mgr.blocking_trigger(
            'following_error_threshold', joint_index)
        joint_config['following_error_threshold'] = r[1].value

        # pwm: extend/retract min/max
        r = self.mgr.blocking_trigger('pwm_limits', joint_index)
        joint_config['pwm'] = {
            'extend_min': r[1].value,
            'extend_max': r[2].value,
            'retract_min': r[3].value,
            'retract_max': r[4].value,
        }

        # adc limits
        r = self.mgr.blocking_trigger('adc_limits', joint_index)
        joint_config['adc'] = {'min': r[1].value, 'max': r[2].value}

        # dither
        r = self.mgr.blocking_trigger('dither')
        joint_config['dither'] = {'time': r[0].value, 'amp': r[1].value}
        return joint_config

    def configure(self, settings):
        """takes a list of commands of form (name, (args))"""
        self.log.debug({'configure': settings})
        for setting in settings:
            cmd, args = setting
            self.mgr.trigger(cmd, *args)

    def merge_calf_calibration(self):
        # merge into setup calibration
        inds = [
            i for (i, v) in enumerate(calibration.setup[self.leg_number])
            if v[0] == 'calf_scale']
        if len(inds) >= 1:
            # remove existing calf scales
            for i in inds[::-1]:
                calibration.setup[self.leg_number].pop(i)
        cal = self.calibrators['calf']
        calibration.setup[self.leg_number].append(
            ('calf_scale', (cal.slope, cal.offset)))

    def compute_calf_zero(self, load=0, merge=True):
        v = self.adc['calf']
        cal = self.calibrators['calf']
        cal.value0 = v
        cal.load0 = load
        cal.old_offset = cal.offset
        cal.compute_offset()
        self.log.info({'compute_calf_zero': {
            'value': v,
            'old_offset': cal.old_offset,
            'offset': cal.offset,
            'slope': cal.slope}})
        # send new calibration to teensy
        self.mgr.trigger('calf_scale', cal.slope, cal.offset)
        # merge into setup calibration?
        if merge:
            self.merge_calf_calibration()

    def on_estop(self, severity):
        #print("Received estop: %s" % severity)
        super(Teensy, self).set_estop(severity.value)

    def send_plan(self, *args, **kwargs):
        super(Teensy, self).send_plan(*args, **kwargs)
        self.mgr.trigger('plan', *self._packed_plan)

    def set_estop(self, value):
        self.mgr.trigger('estop', value)
        super(Teensy, self).set_estop(value)

    def set_pwm(self, hip, thigh, knee):
        self.mgr.trigger('pwm', hip, thigh, knee)
        super(Teensy, self).set_pwm(hip, thigh, knee)

    def enable_pid(self, value):
        self.mgr.trigger('enable_pid', value)
        super(Teensy, self).enable_pid(value)

    def on_report_adc(self, hip, thigh, knee, calf):
        self.adc = {
            'hip': hip.value, 'thigh': thigh.value,
            'knee': knee.value, 'calf': calf.value,
            'time': time.time()}
        self.log.debug({'adc': self.adc})
        self.trigger('adc', self.adc)

    def on_report_xyz(self, x, y, z):
        t = time.time()
        x, y, z = x.value, y.value, z.value
        self.xyz = {
            'x': x, 'y': y, 'z': z,
            'time': t}
        self.log.debug({'xyz': self.xyz})
        self.trigger('xyz', self.xyz)

    def on_report_angles(self, h, t, k, c, v):
        self.angles = {
            'hip': h.value, 'thigh': t.value, 'knee': k.value,
            'calf': c.value,
            'valid': bool(v), 'time': time.time()}
        self.log.debug({'angles': self.angles})
        self.trigger('angles', self.angles)

    def on_report_pid(self, ho, to, ko, hs, ts, ks, he, te, ke):
        self.pid = {
            'time': time.time(),
            'output': {
                'hip': ho.value,
                'thigh': to.value,
                'knee': ko.value,
            },
            'set_point': {
                'hip': hs.value,
                'thigh': ts.value,
                'knee': ks.value,
            },
            'error': {
                'hip': he.value,
                'thigh': te.value,
                'knee': ke.value,
            }}
        self.log.debug({'pid': self.pid})
        self.trigger('pid', self.pid)

    def on_report_pwm(self, h, t, k):
        """
        if hasattr(self, '_hv'):
            hv = h.value
            ts = time.time()
            if abs(hv - self._hv['h']) > 250.:
                # new hip value
                #print("HV: %s [%s]" % (hv, ts - self._hv['t']))
                self._hv = {'h': hv, 't': ts}
        else:
            self._hv = {
                'h': h.value,
                't': time.time()}
        """
        self.pwm = {
            'hip': h.value, 'thigh': t.value, 'knee': k.value,
            'time': time.time()}
        self.log.debug({'pwm': self.pwm})
        self.trigger('pwm', self.pwm)

    def on_report_loop_time(self, t):
        self.loop_time_stats.update(t.value)
        self.log.debug({'loop_time': t.value})
        self.trigger('loop_time', t.value)

    def send_heartbeat(self):
        self.mgr.trigger('heartbeat')
        self.last_heartbeat = time.time()
        # print("HB: %s" % self.last_heartbeat)

    def update(self):
        try:
            self.com.handle_stream()
        except Exception as e:
            ex_type, ex, tb = sys.exc_info()
            print("Leg %s handle stream error: %s" % (self.leg_number, e))
            tbs = '\n'.join(traceback.format_tb(tb))
            self.log.error("handle_stream error: %s" % e)
            print(tbs)
            self.log.error({'error': {
                'traceback': tbs,
                'exception': e}})
            raise e
        if (time.time() - self.last_heartbeat) > consts.HEARTBEAT_PERIOD:
            self.send_heartbeat()


def connect_to_teensies(ports=None):
    """Return dict with {leg_number: teensy}"""
    if ports is None:
        #tinfo = utils.find_leg_teensies()
        #ports = [i['port'] for i in tinfo]
        ports = [t['port'] for t in utils.find_teensies_by_type('leg')]
        if any([p is None for p in ports]):
            print(
                'Leg teensies: %s' % (utils.find_teensies_by_type('leg'), ))
            raise IOError("Failed to find port for a leg teensy")

    if len(ports) == 0:
        return {ln: FakeTeensy(ln) for ln in [1, 2, 3, 4, 5, 6]}
        #return {ln: FakeTeensy(ln) for ln in [1, 3, 4, 6]}
    teensies = [Teensy(p) for p in ports]
    lnd = {}
    for t in teensies:
        ln = t.leg_number
        lnd[ln] = lnd.get(ln, []) + [t, ]
    for ln in lnd:
        if len(lnd[ln]) > 1:
            raise Exception(
                "Found >1 teensies with the same leg number: %s[%s]" %
                (ln, lnd[ln]))
        lnd[ln] = lnd[ln][0]
    return lnd
