braingram/stompy/stompy/statics.py

#!/usr/bin/env python
"""
Store state of all feet + legs so things do not have to register for signals?

Use roll, pitch, yaw and height to compute CG

Use roll, pitch, yaw and foot positions, measure flatness of ground

For support polygon (and 'height') need to know:
    - foot xyz positions in body coordinates
    - foot states (loaded vs unloaded: stance/wait vs lift/lower/swing)

For CG need to know:
    - support triangle (see above)
    - height (see above)
    - roll & pitch to scale projection of CM onto support triangle
"""

import math

import numpy

from . import signaler
from . import transforms


def point_to_line_2d(pt, l1, l2):
    x0, y0 = pt[0], pt[1]
    x1, y1 = l1[0], l1[1]
    x2, y2 = l2[0], l2[1]
    return (
        abs((y2 - y1) * x0 - (x2 - x1) * y0 + x2 * y1 - y2 * x1) / 
        math.sqrt((y2 - y1) ** 2 + (x2 - x1) ** 2))


class Stance(signaler.Signaler):
    _loaded_states = ('stance', 'wait', 'loaded')
    def __init__(self, legs):
        super(Stance, self).__init__()
        self.leg_positions = {}
        self.leg_states = {}
        for leg in legs:
            self.leg_positions[leg] = None
            self.leg_states[leg] = None
        self.heading = None
        self.pose_plane = None
        self.slope = None
        self.height = None
        self.support_polygon = None
        # TODO probably higher up and some inches back
        self.COM = numpy.array([0.0, 0.0, 0.0])
        self.COG = numpy.array([0.0, 0.0, 0.0])

    def on_leg_xyz(self, body_xyz, leg_number):
        # assume xyz is in body coordinates, no reason to know leg coordinates
        self.leg_positions[leg_number] = body_xyz
        # if leg is 'supporting' update support triangle
        if leg_number not in self.leg_states:
            return
        if self.leg_states[leg_number] in self._loaded_states:
            self.update_support_polygon()

    def on_leg_state(self, state, leg_number):
        if leg_number in self.leg_states:
            old_state = self.leg_states[leg_number]
        else:
            old_state = None
        self.leg_states[leg_number] = state
        # if leg is now or was 'supporting' update support triangle
        if (
                state in self._loaded_states or
                old_state in self._loaded_states):
            self.update_support_polygon()

    def on_imu_heading(self, roll, pitch, yaw):
        # - roll = left side of body is lower
        # - pitch = nose is lower
        # roll -3.3, pitch 1.7
        # heading (-3.3021730483155509, 1.698265784377885, 0.0069093329155734294)
        # pose_plane (0.042723203630698529, 0.070985722381526437)
        self.heading = (roll, pitch, yaw)
        self.update_cog()
        self.update_ground_slope()

    def update_support_polygon(self):
        self.support_polygon = []
        support_legs = []
        for leg in sorted(self.leg_states):
            if self.leg_states[leg] in self._loaded_states:
                if (
                        leg not in self.leg_positions or
                        self.leg_positions[leg] is None):
                    # not enough data to compute support polygon
                    self.support_polygon = None
                    return
                self.support_polygon.append(self.leg_positions[leg])
                support_legs.append(leg)
        # compute height by taking average of all zs
        self.support_polygon = numpy.array(self.support_polygon)
        self.trigger('support_legs', support_legs)
        self.trigger('support_polygon', self.support_polygon)
        if self.support_polygon is not None and len(self.support_polygon):
            self.height = -numpy.mean(self.support_polygon[:, 2])
            self.trigger('height', self.height)
            if self.COG is not None:
                self.update_stability_margin()
            if len(self.support_polygon) > 2:
                self.update_pose_plane()

    def update_pose_plane(self):
        if self.support_polygon is None or len(self.support_polygon) < 3:
            return
        # TODO throttle?
        # take lowest 3 feet, fit plane, get roll and pitch of plane
        p = self.support_polygon[self.support_polygon[:, 2].argsort()[:3]]
        # get furthest forward point (most y positive) = p0
        inds = [0, 1, 2]
        p0i = p[:, 1].argmax()
        inds.remove(p0i)
        p0 = p[p0i]
        p1, p2 = p[inds]

        # get leftmost of other 2 points (most x negative) = p1
        # other is p2
        if p2[0] < p1[0]:
            p1, p2 = p2, p1

        # compute normal: normal = numpy.cross(p1 - p0, p2 - p0)
        n = numpy.cross(p1 - p0, p2 - p0)

        # should go UP
        if n[2] < 0:
            p1, p2 = p2, p1
            n = numpy.cross(p1 - p0, p2 - p0)
            if n[2] < 0:
                print("That's not supposed to happen...[z should be >= 0]:", n)
                print(p0, p1, p2)
                return

        # compute pitch of normal using Z and Y: arctan(Y, Z)
        # TODO - pitch when front feet are lower
        pitch = -math.atan2(n[1], n[2])

        # compute roll of normal using Z and X: arctan(X, Z)
        # TODO + roll when right feet are lower
        roll = math.atan2(n[0], n[2])
        self.pose_plane = math.degrees(roll), math.degrees(pitch)
        self.trigger('pose_plane', self.pose_plane)

        self.update_ground_slope()

    def update_ground_slope(self):
        if self.heading is None or self.pose_plane is None:
            return
        # TODO throttle?
        # correct heading pitch and yaw for slope of ground
        # report ground slope
        # self.heading (roll, pitch, yaw)
        # - roll = left side of body is lower
        # - pitch = nose is lower
        # self.pose_plane roll, pitch
        #  -- first test --
        # roll -3.3, pitch 1.7
        # heading (-3.3021730483155509, 1.698265784377885, 0.0069093329155734294)
        # pose_plane (0.070985722381526437, 0.042723203630698529)
        # pose_plane[degrees] = [4.01, 2.29]

        # ground_slope = roll, pitch
        self.ground_slope = (
            self.heading[0] + self.pose_plane[0],
            self.heading[1] + self.pose_plane[1])
        self.trigger('ground_slope', self.ground_slope)

    def update_cog(self):
        """compute center of gravity using center of mass and roll and pitch"""
        if self.height is None or self.heading is None:
            return
        # TODO throttle?
        # project COM down by height by pitch and roll
        roll, pitch, yaw = self.heading
        R = transforms.rotation_3d(pitch, roll, 0., degrees=True)
        self.COG = transforms.transform_3d(
            R, self.COM[0], self.COM[1], self.height)
        self.trigger('COG', self.COG)
        if self.support_polygon is not None and len(self.support_polygon):
            self.update_stability_margin()

    def update_stability_margin(self):
        if self.support_polygon is None or len(self.support_polygon) < 3:
            return
        # TODO throttle?
        if self.COG is None:
            cg = self.COM
        else:
            cg = self.COG
        # only do this in XY
        l0 = self.support_polygon[0]
        min_d = numpy.inf
        for l1 in self.support_polygon[1:]:
            min_d = min(point_to_line_2d(cg, l0, l1), min_d)
            l0 = l1
        l1 = self.support_polygon[0]
        min_d = min(point_to_line_2d(cg, l0, l1), min_d)
        self.trigger('stability_margin', min_d)
