braingram/stompy/stompy/ui/ui.py

#!/usr/bin/env python

import os
import sys
import time
import traceback

import numpy

from PyQt5 import QtCore, QtGui, uic
from PyQt5.QtWidgets import (
    QGestureEvent, QPinchGesture,
    QSwipeGesture, QDialog,
    QWidget, QApplication, QMainWindow,
    QAction, QInputDialog)


from .. import calibration
from .. import consts
from .. import controller
from .. import joystick
from .joystick import make_joystick_window
from .. import log
from . import nogl
from .. import remote


this_dir = os.path.dirname(os.path.abspath(__file__))
ui_filename = os.path.join(this_dir, 'stompy.ui')
dialog_ui_filename = os.path.join(this_dir, 'dialog.ui')


def launch_dialog(name, value, meta):
    dialog = QDialog()
    ui = uic.loadUi(dialog_ui_filename, dialog)

    # setup value display
    if 'min' in meta:
        ui.doubleSpinBox.setMinimum(meta['min'])
    else:
        if value > 0:
            ui.doubleSpinBox.setMinimum(value * 0.1)
        else:
            ui.doubleSpinBox.setMinimum(value * 10.)
    if 'max' in meta:
        ui.doubleSpinBox.setMaximum(meta['max'])
    else:
        if value > 0:
            ui.doubleSpinBox.setMaximum(value * 10.)
        else:
            ui.doubleSpinBox.setMaximum(value * 0.1)
    if 'step' in meta:
        ui.doubleSpinBox.setSingleStep(meta['step'])
    else:
        ui.doubleSpinBox.setSingleStep(value * 0.1)
    if 'decimals' in meta:
        ui.doubleSpinBox.setDecimals(meta['decimals'])
    else:
        pass
    #for a in ('minimum', 'maximum', 'singleStep', 'decimals'):
    #    print(a, getattr(ui.doubleSpinBox, a)())
    #print("Setting value:", value)
    ui.doubleSpinBox.setValue(value)
    #print("Value:", ui.doubleSpinBox.value())
    ui.spin_text = ""

    def clear_text():
        ui.spin_text = ""
        ui.doubleSpinBox.clear()

    # connect to clear button
    ui.clearButton.clicked.connect(clear_text)

    def next_value(clicked, v):
        if v == '-':
            if len(ui.spin_text) and ui.spin_text == '-':
                ui.spin_text = ui.spin_text[1:]
            else:
                ui.spin_text = '-' + ui.spin_text
        else:
            ui.spin_text += str(v)
        sv = ui.doubleSpinBox.valueFromText(ui.spin_text)
        ui.doubleSpinBox.setValue(sv)

    # connect up buttons
    for i in range(10):
        w = getattr(ui, 'pushButton_%i' % i)
        w.clicked.connect(lambda c, v=i: next_value(c, v))

    ui.pushButton_p.clicked.connect(lambda c: next_value(c, '.'))
    ui.pushButton_n.clicked.connect(lambda c: next_value(c, '-'))

    if dialog.exec_():  # 0 if closed/canceled, 1 if OK
        # set new value
        return type(value)(ui.doubleSpinBox.value()), True
    return value, False


class Tab(object):
    def __init__(self, ui, controller):
        self.ui = ui
        self.controller = controller
        if self.controller is not None:
            self._last_leg_index = None
            self.controller.on('', 'set_leg', self.set_leg_index)
            self.set_leg_index(
                self.controller.get('leg_index'))

    def set_leg_index(self, index):
        self._last_leg_index = index

    def start_showing(self):
        pass

    def stop_showing(self):
        pass


class PIDTab(Tab):
    n_points = 1000

    def __init__(self, ui, controller):
        self.chart = ui.pidLineChart
        self.chart.addSeries('Setpoint')
        self.chart.addSeries('Output')
        self.chart.addSeries('Error')

        super(PIDTab, self).__init__(ui, controller)
        self.joint_config = {}

        self.ui.pidJointCombo.currentIndexChanged.connect(
            self.change_joint)
        self.ui.pidCommitButton.clicked.connect(
            self.commit_values)

        self.change_joint()

    def set_leg_index(self, index):
        if self.controller is None:
            return
        if self._last_leg_index is not None:
            self.controller.remove_on(
                'legs[%s]' % self._last_leg_index,
                'pid', self.on_pid)
        super(PIDTab, self).set_leg_index(index)  # update index
        if index is not None:
            self.controller.on(
                'legs[%s]' % index,
                'pid', self.on_pid)

    def add_pid_values(self, output, setpoint, error):
        self.chart.appendData('Setpoint', setpoint)
        self.chart.appendData('Output', output)
        self.chart.appendData('Error', error)
        self.chart.update()

    def on_pid(self, pid):
        txt = str(self.ui.pidJointCombo.currentText()).lower()
        o, s, e = pid['output'], pid['set_point'], pid['error']
        if txt not in o:
            return
        self.add_pid_values(o[txt], s[txt], e[txt])

    def change_joint(self):
        self.clear_pid_values()
        self.read_joint_config()

    def read_joint_config(self):
        # get current joint
        txt = str(self.ui.pidJointCombo.currentText()).lower()
        self.joint_config = self.controller.call(
            'leg.pid_joint_config', txt)

        # set ui elements by joint_config
        if 'pid' in self.joint_config:
            if 'p' in self.joint_config['pid']:
                self.ui.pidPSpin.setValue(self.joint_config['pid']['p'])
            if 'i' in self.joint_config['pid']:
                self.ui.pidISpin.setValue(self.joint_config['pid']['i'])
            if 'd' in self.joint_config['pid']:
                self.ui.pidDSpin.setValue(self.joint_config['pid']['d'])
            if 'min' in self.joint_config['pid']:
                self.ui.pidMinSpin.setValue(self.joint_config['pid']['min'])
            if 'max' in self.joint_config['pid']:
                self.ui.pidMaxSpin.setValue(self.joint_config['pid']['max'])
        if 'pwm' in self.joint_config:
            if 'extend_min' in self.joint_config['pwm']:
                self.ui.extendMinSpin.setValue(
                    self.joint_config['pwm']['extend_min'])
            if 'extend_max' in self.joint_config['pwm']:
                self.ui.extendMaxSpin.setValue(
                    self.joint_config['pwm']['extend_max'])
            if 'retract_min' in self.joint_config['pwm']:
                self.ui.retractMinSpin.setValue(
                    self.joint_config['pwm']['retract_min'])
            if 'retract_max' in self.joint_config['pwm']:
                self.ui.retractMaxSpin.setValue(
                    self.joint_config['pwm']['retract_max'])
        if 'following_error_threshold' in self.joint_config:
            self.ui.pidErrorThresholdSpin.setValue(
                self.joint_config['following_error_threshold'])
        if 'adc' in self.joint_config:
            if 'min' in self.joint_config['adc']:
                self.ui.adcLimitMinSpin.setValue(
                    self.joint_config['adc']['min'])
            if 'max' in self.joint_config['adc']:
                self.ui.adcLimitMaxSpin.setValue(
                    self.joint_config['adc']['max'])
        if 'dither' in self.joint_config:
            if 'time' in self.joint_config['dither']:
                self.ui.ditherTimeSpin.setValue(
                    self.joint_config['dither']['time'])
            if 'amp' in self.joint_config['dither']:
                self.ui.ditherAmpSpin.setValue(
                    self.joint_config['dither']['amp'])

    def commit_values(self):
        # compare ui to joint config
        txt = str(self.ui.pidJointCombo.currentText()).lower()

        if txt not in consts.JOINT_INDEX_BY_NAME:
            return {}
        index = consts.JOINT_INDEX_BY_NAME[txt]

        settings = []
        # compare self.joint_config to values make settings
        if 'pid' in self.joint_config:
            j = self.joint_config['pid']
            v = {
                'p': self.ui.pidPSpin.value(),
                'i': self.ui.pidISpin.value(),
                'd': self.ui.pidDSpin.value(),
                'min': self.ui.pidMinSpin.value(),
                'max': self.ui.pidMaxSpin.value(),
            }

            if (
                    v['p'] != j['p'] or
                    v['i'] != j['i'] or
                    v['d'] != j['d'] or
                    v['min'] != j['min'] or
                    v['max'] != j['max']):
                settings.append((
                    'pid_config',
                    (index, v['p'], v['i'], v['d'], v['min'], v['max'])))

        if 'following_error_threshold' in self.joint_config:
            v = self.ui.pidErrorThresholdSpin.value()
            j = self.joint_config['following_error_threshold']
            if (v != j):
                settings.append((
                    'following_error_threshold', (index, float(v))))

        if 'pwm' in self.joint_config:
            j = self.joint_config['pwm']
            v = {
                'extend_min': self.ui.extendMinSpin.value(),
                'extend_max': self.ui.extendMaxSpin.value(),
                'retract_min': self.ui.retractMinSpin.value(),
                'retract_max': self.ui.retractMaxSpin.value(),
            }
            if (
                    v['extend_min'] != j['extend_min'] or
                    v['extend_max'] != j['extend_max'] or
                    v['retract_min'] != j['retract_min'] or
                    v['retract_max'] != j['retract_max']):
                settings.append((
                    'pwm_limits',
                    (index,
                    int(v['extend_min']),
                    int(v['extend_max']),
                    int(v['retract_min']),
                    int(v['retract_max']))))

        if 'adc' in self.joint_config:
            j = self.joint_config['adc']
            v = {
                'min': self.ui.adcLimitMinSpin.value(),
                'max': self.ui.adcLimitMaxSpin.value(),
            }
            if (v['min'] != j['min'] or v['max'] != j['max']):
                settings.append((
                    'adc_limits',
                    (index, v['min'], v['max'])))

        if 'dither' in self.joint_config:
            j = self.joint_config['dither']
            v = {
                'time': self.ui.ditherTimeSpin.value(),
                'amp': self.ui.ditherAmpSpin.value(),
            }
            if (v['time'] != j['time'] or v['amp'] != j['amp']):
                settings.append((
                    'dither',
                    (int(v['time']), int(v['amp']))))

        self.controller.no_return_call('leg.configure', settings)
        self.read_joint_config()

    def clear_pid_values(self):
        self.chart.clearData()
        self.chart.update()

    def timer_update(self):
        rd = list(numpy.random.random(3))
        self.add_pid_values(*rd)

    def start_showing(self):
        self.clear_pid_values()
        if self.controller is None:
            print("starting timer")
            self.timer = QtCore.QTimer()
            self.timer.timeout.connect(self.timer_update)
            self.timer.start(50)

    def stop_showing(self):
        if self.controller is None:
            self.timer.stop()


class LegTab(Tab):
    def __init__(self, ui, controller):
        self.display = ui.legDisplay
        super(LegTab, self).__init__(ui, controller)
        self.display.set_view('right')

    def set_leg_index(self, index):
        if self.controller is None:
            return
        if self._last_leg_index is not None:
            lo = 'legs[%i]' % self._last_leg_index
            self.controller.remove_on(lo, 'angles', self.on_angles)
            self.controller.remove_on(lo, 'xyz', self.on_xyz)
            self.controller.remove_on(lo, 'adc', self.on_adc)
            self.controller.remove_on(
                'res.feet[%i]' % self._last_leg_index,
                'restriction', self.on_restriction)
        super(LegTab, self).set_leg_index(index)  # update index
        self.display.leg.number = index
        self.display.update()
        if index is not None:
            lo = 'legs[%i]' % index
            self.controller.on(lo, 'angles', self.on_angles)
            self.controller.on(lo, 'xyz', self.on_xyz)
            self.controller.on(lo, 'adc', self.on_adc)
            self.controller.on(
                'res.feet[%i]' % index,
                'restriction', self.on_restriction)

    def plot_leg(self, hip, thigh, knee):
        self.display.leg.set_angles(hip, thigh, knee)
        self.display.update()
        return

    def update_timer(self):
        self.plot_leg(self.angles[0], self.angles[1], self.angles[2])
        for i in xrange(3):
            self.angles[i] += self.deltas[i]
            if (
                    self.angles[i] > self.limits[i][0] or
                    self.angles[i] < self.limits[i][1]):
                self.deltas[i] *= -1

    def on_angles(self, angles):
        # TODO what to do when v is False?
        self.plot_leg(angles['hip'], angles['thigh'], angles['knee'])
        self.ui.legLLineEdit.setText('%0.2f' % angles['calf'])

    def on_xyz(self, xyz):
        self.ui.legXLineEdit.setText('%0.2f' % xyz['x'])
        self.ui.legYLineEdit.setText('%0.2f' % xyz['y'])
        self.ui.legZLineEdit.setText('%0.2f' % xyz['z'])

    def on_restriction(self, r):
        self.ui.legRLineEdit.setText('%0.2f' % r['r'])

    def on_adc(self, adc):
        self.ui.hipADCProgress.setValue(adc['hip'])
        self.ui.thighADCProgress.setValue(adc['thigh'])
        self.ui.kneeADCProgress.setValue(adc['knee'])
        self.ui.calfADCProgress.setValue(adc['calf'])

    def start_showing(self):
        if self.controller is None:
            self.angles = [0., 0., 0.]
            self.deltas = [0.01, 0.01, -0.02]
            self.limits = [[0.6, -0.6], [1.1, 0.], [0., -1.1]]
            self.timer = QtCore.QTimer()
            self.timer.timeout.connect(self.update_timer)
            self.timer.start(50)

    def stop_showing(self):
        if self.controller is None:
            self.timer.stop()


class BodyTab(Tab):
    def __init__(self, ui, controller):
        self.display = ui.bodyDisplay
        super(BodyTab, self).__init__(ui, controller)
        self.heightLabel = ui.heightLabel
        self.haltLabel = ui.haltLabel

        # attach to all legs
        self.controller.on('stance', 'height', self.on_height)
        self.controller.on('stance', 'COG', self.on_COG)
        self.controller.on('stance', 'support_legs', self.on_support_legs)
        self.controller.on('', 'mode', self.on_mode)
        self.controller.on('res', 'halt', self.on_halt)
        for leg_number in self.controller.call('legs.keys'):
            self.display.add_leg(leg_number)
            lo = 'legs[%i]' % leg_number
            self.controller.on(
                lo, 'angles', lambda a, i=leg_number: self.on_angles(a, i))
            #self.controller.on(
            #    lo, 'xyz', lambda a, i=leg_number: self.on_xyz(a, i))
            ro = 'res.feet[%i]' % leg_number
            self.controller.on(
                ro, 'restriction',
                lambda a, i=leg_number: self.on_restriction(a, i))
            self.controller.on(
                ro,
                'state', lambda a, i=leg_number: self.on_res_state(a, i))
        self.display.set_view('top')

    def set_leg_index(self, index):
        if self.controller is None:
            return
        self.display.selected_leg = index
        super(BodyTab, self).set_leg_index(index)

    def plot_leg(self, leg_number, hip, thigh, knee, calf):
        self.display.legs[leg_number].set_angles(hip, thigh, knee, calf)
        self.display.update()
        return

    def on_angles(self, angles, leg_number):
        self.plot_leg(
            leg_number, angles['hip'], angles['thigh'], angles['knee'],
            angles['calf'])

    #def on_xyz(self, xyz, leg_number):
    #    pass

    def on_restriction(self, res, leg_number):
        self.display.legs[leg_number].restriction = res
        self.display.update()
        return

    def on_halt(self, halted):
        if halted:
            self.haltLabel.setText("Halted")
            self.haltLabel.setStyleSheet("background-color: red;")
        else:
            self.haltLabel.setText("unhalted")
            self.haltLabel.setStyleSheet("background-color: none;")

    def on_height(self, height):
        self.heightLabel.setText("Height: %0.2f" % height)

    def on_COG(self, COG):
        self.display.COG = COG
        self.display.update()

    def on_mode(self, mode):
        if mode == 'walk':
            self._update_support_legs()
        else:
            self.display.support_legs = []

    def on_res_state(self, state, leg_number):
        # TODO throttle path updates
        if not hasattr(self, '_path_update'):
            self._path_update = time.time()
        if (time.time() - self._path_update) > 5.0:
            self._update_support_legs()
            self._path_update = time.time()
            self.display.path = [
                p['position'] for p in
                self.controller.call('res.odo.get_path')]

    def on_support_legs(self, support_legs):
        self.display.support_legs = support_legs
        self.display.update()

    def _update_support_legs(self):
        return  # TODO move this to the backend
        # draw polygon between supported legs
        lns = sorted(self.controller.call('res.feet.keys'))
        support_legs = []
        for ln in lns:
            if (
                    self.controller.get('res.feet[%i].state' % ln)
                    in ('stance', 'wait')):
                support_legs.append(ln)
        if not len(support_legs):
            return
        self.display.support_legs = support_legs
        self.display.update()
        # TODO calculate pitch and roll


class TabManager(object):
    def __init__(self, tab_widget):
        self.tab_widget = tab_widget
        self.tab_widget.currentChanged.connect(self.tab_changed)
        self.tabs = {}
        self.current = None

    def show_current(self):
        i = self.tab_widget.currentIndex()
        if i == -1:
            return
        self.tab_changed(i)

    def add_tab(self, name, tab):
        self.tabs[name] = tab

    def tab_changed(self, index):
        # lookup index
        label = str(self.tab_widget.tabText(index))
        if self.current is not None:
            self.current.stop_showing()
            self.current = None
        if label in self.tabs:
            self.tabs[label].start_showing()
            self.current = self.tabs[label]


def load_ui(controller=None):
    # make things bigger for high dpi displays
    if hasattr(QtCore.Qt, 'AA_EnableHighDpiScaling'):
        QApplication.setAttribute(QtCore.Qt.AA_EnableHighDpiScaling, True)

    if hasattr(QtCore.Qt, 'AA_UseHighDpiPixmaps'):
        QApplication.setAttribute(QtCore.Qt.AA_UseHighDpiPixmaps, True)

    app = QApplication(sys.argv)
    MainWindow = QMainWindow()
    #ui = base.Ui_MainWindow()
    ui = uic.loadUi(ui_filename, MainWindow)
    #ui.setupUi(MainWindow)
    # setup menus
    ui._calibrationMenu_actions = []
    a = QAction("Save", ui.calibrationMenu)
    a.triggered.connect(lambda a: calibration.save_calibrations())
    ui._calibrationMenu_actions.append(a)
    ui.calibrationMenu.addAction(a)
    if controller is not None:
        if controller.get('_fake_legs'):
            # TODO might be easier/cleaner to fake a joystick
            # this code is dangerous as it disables the estops
            #controller.set('deadman', True)
            #controller.call('all_legs', 'set_estop', 0)

            def key_press(e):
                #print("key_pressed: %s" % (e, ))
                #if e.modifiers() & QtCore.Qt.ShiftModifier:
                #    print(" shift down!")
                k = e.key()
                #print(" key: %s" % (k, ))
                if k == QtCore.Qt.Key_Up:
                    # send forward plan
                    controller.no_return_call('set_target', [0., 1., 0.])
                elif k == QtCore.Qt.Key_Down:
                    # send backward plan
                    controller.no_return_call('set_target', [0., -1., 0.])
                # TODO turning
                elif k == QtCore.Qt.Key_Escape:
                    # send 0 plan
                    controller.no_return_call('set_target', [0., 0., 0.])

            MainWindow.keyPressEvent = key_press
        a = QAction("Zero calf", ui.calibrationMenu)
        a.triggered.connect(
            lambda a: controller.no_return_call('leg.compute_calf_zero'))
        ui._calibrationMenu_actions.append(a)
        ui.calibrationMenu.addAction(a)

        ui._legsMenu_actions = []
        legs = list(controller.call('legs.keys'))
        for leg in legs:
            a = QAction(
                consts.LEG_NAME_BY_NUMBER[leg], ui.legsMenu)
            a.triggered.connect(
                lambda a, i=leg: controller.no_return_call('set_leg', i))
            ui._legsMenu_actions.append(a)
            ui.legsMenu.addAction(a)

        # enable/disable leg radio buttons
        for i in range(1, 7):
            r = getattr(ui, 'leg%iRadioButton' % i)
            if i in legs:
                r.setEnabled(True)
                # attach leg select to click
                r.clicked.connect(
                    lambda c, li=i: controller.no_return_call('set_leg', li))
            else:
                r.setEnabled(False)

        ui._modesMenu_actions = []
        modes = controller.get('modes')
        for mode in modes:
            a = QAction(mode, ui.modesMenu)
            a.triggered.connect(
                lambda a, m=mode: controller.no_return_call('set_mode', m))
            ui._modesMenu_actions.append(a)
            ui.modesMenu.addAction(a)
        current_mode = controller.get('mode')
        # enable/disable mode radio buttons
        for mode in modes:
            n = '%sRadioButton' % mode
            if not hasattr(ui, n):
                continue
            r = getattr(ui, n)
            r.setEnabled(True)
            if mode == current_mode:
                r.setChecked(True)
            r.clicked.connect(
                lambda c, m=mode: controller.no_return_call('set_mode', m))
        ui.modesMenu.setTitle("Mode: %s" % current_mode)
        ui.legsMenu.setTitle(
            "Leg: %s" % consts.LEG_NAME_BY_NUMBER[controller.get('leg_index')])

        def on_mode(mode):
            ui.modesMenu.setTitle("Mode: %s" % mode)
            n = '%sRadioButton' % mode
            if not hasattr(ui, n):
                # TODO uncheck all other modes?
                return
            r = getattr(ui, n)
            r.setChecked(True)

        controller.on( '', 'mode', on_mode)
        #controller.on(
        #    '', 'mode', lambda m: ui.modesMenu.setTitle("Mode: %s" % m))

        def on_leg(leg):
            ui.legsMenu.setTitle("Leg: %s" % consts.LEG_NAME_BY_NUMBER[leg])
            r = getattr(ui, 'leg%iRadioButton' % leg)
            r.setChecked(True)

        controller.on('', 'set_leg', on_leg)
        #controller.on('', 'set_leg', lambda m: ui.legsMenu.setTitle(
        #    "Leg: %s" % consts.LEG_NAME_BY_NUMBER[m]))
        controller.on('', 'estop', lambda v: (
            ui.estopLabel.setText(
                "Estop: %s" % consts.ESTOP_BY_NUMBER[v]),
            ui.estopLabel.setStyleSheet((
                "background-color: green;" if v == consts.ESTOP_OFF else
                "background-color: none;"))
        ))
    tm = TabManager(ui.tabs)
    tm.add_tab('PID', PIDTab(ui, controller))
    tm.add_tab('Leg', LegTab(ui, controller))
    tm.add_tab('Body', BodyTab(ui, controller))
    tm.show_current()

    controller.on(
            'stance', 'stability_margin',
            lambda v: ui.stabilityLabel.setText("Stability: %.0f" % v))
    if 'imu' in controller.call('bodies.keys'):
        controller.on(
            'bodies["imu"]',
            'feed_pressure', lambda v: ui.pressureLabel.setText("PSI: %i" % v))
        controller.on(
            'bodies["imu"]',
            'engine_rpm', lambda v: ui.rpmLabel.setText("RPM: %0.0f" % v))
        controller.on(
            'bodies["imu"]',
            'feed_oil_temp',
            lambda v: ui.oilTempLabel.setText("Temp: %0.2f" % v))

        def new_heading(roll, pitch, yaw):
            ui.rollLabel.setText("Roll: %0.1f" % roll)
            ui.pitchLabel.setText("Pitch: %0.1f" % pitch)
            ui.yawLabel.setText("Yaw: %0.1f" % yaw)

        controller.on('bodies["imu"]', 'heading', new_heading)
        #controller.on(
        #    'bodies["imu"]',
        #    'heading',
        #    lambda r, p, y: ui.imuLabel.setText(
        #        "IMU: %0.2f %0.2f %0.2f" % (r, p, y)))

    # param changes
    def new_speed(value):
        ui.speedSlider.setValue(value)
        ui.speedLabel.setText(str(value))
        controller.call('set_target')

    controller.on(
        'param', 'speed.foot', new_speed)
    ui.speedSlider.valueChanged.connect(
        lambda v: controller.call('param.set_param', 'speed.foot', v))
    spd = controller.get("param['speed.foot']")
    ui.speedSlider.setValue(spd)
    ui.speedLabel.setText(str(spd))
    ui._configurationMenu_actions = []
    ui._configurationMenu_submenus = {}
    for name in sorted(controller.call('param.list_params')):
        # make submenus
        menu = ui.configurationMenu
        if '.' in name:
            # split submenus from name (leaving out last key)
            sn = name.split('.')
            subname = sn[-1]
            sn = sn[:-1]
            sd = ui._configurationMenu_submenus
            n = ""
            for ssn in sn:
                if len(n):
                    n = '%s.%s' % (n, ssn)
                else:
                    n = ssn
                if n not in sd:
                    #print("adding menu %s to %s" % (ssn, menu))
                    ui._configurationMenu_submenus[n] = menu.addMenu(ssn)
                menu = ui._configurationMenu_submenus[n]
            menu = ui._configurationMenu_submenus['.'.join(sn)]
        else:
            subname = name

        # add item to menu
        # when clicked show InputDialog (or have check mark)
        value = controller.get('param["%s"]' % name)
        if isinstance(value, bool):
            a = QAction(
                subname, menu, checkable=True, checked=value)
            a.triggered.connect(
                (
                    lambda value, n=name:
                    controller.no_return_call('param.set_param', n, value)))
            controller.on(
                'param', name, lambda nv, action=a: action.setChecked(nv))
        else:
            a = QAction('[%s] %s' % (value, subname), menu)

            def prompt_for_value(value, n=name):
                cv = controller.get('param["%s"]' % n)
                meta = controller.call('param.get_meta', n, {})
                #    if isinstance(cv, float):
                #        f = QInputDialog.getDouble
                #    else:
                #        f = QInputDialog.getInt
                #    kwargs = controller.call('param.get_meta', n, {})
                #    nv, ok = f(MainWindow, n, n, cv, **kwargs)
                #print(n, cv, meta, value)
                nv, ok = launch_dialog(n, cv, meta)
                if ok:
                    controller.set('param["%s"]' % n, nv)

            if isinstance(value, float):
                fmt = '[%0.2f] %s'
            elif isinstance(value, int):
                fmt = '[%i] %s'
            else:
                fmt = '[%s] %s'

            def set_text(nv, action=a, n=subname, fmt=fmt):
                action.setText(fmt % (nv, n))

            # have title include value?
            controller.on(
                'param', name, set_text)
            #controller.param.on(
            #    name, lambda nv, action=a, n=name: action.setText(
            #        '[%s]%s' % (nv, n)))
            a.triggered.connect(prompt_for_value)
        ui._configurationMenu_actions.append(a)
        menu.addAction(a)

    MainWindow.show()
    #MainWindow.showFullScreen()
    timer = None
    if controller is not None:
        timer = QtCore.QTimer()

        def update():
            try:
                controller.update()
                controller.joy.update()
            except Exception as e:
                ex_type, ex, tb = sys.exc_info()
                print("controller update error: %s" % e)
                traceback.print_tb(tb)
                # TODO stop updates on error?
                #timer.stop()
        #timer.timeout.connect(controller.update)
        timer.timeout.connect(update)
        timer.start(10)
    return {
        'app': app, 'ui': ui, 'window': MainWindow, 'tab_manager': tm,
        'timer': timer}


def run_ui(ui):
    sys.exit(ui['app'].exec_())


def start(remote_ui=False):
    if remote_ui:
        c = remote.client.RPCClient()
    else:
        c = remote.agent.RPCAgent(controller.build())
        c.update = c.obj.update
    ui = load_ui(c)
    # connect to joystick
    if joystick.ps3.available():
        joy = joystick.ps3.PS3Joystick()
    elif joystick.steel.available():
        joy = joystick.steel.SteelJoystick()
    else:
        joy = joystick.fake.FakeJoystick()
        c._joy_ui = make_joystick_window(joy)
    # setup callbacks
    joy.on(
        'buttons',
        lambda d: [c.call('joy._report_button', n, d[n]) for n in d])
    joy.on(
        'axes',
        lambda d: [c.call('joy._report_axis', n, d[n]) for n in d])

    # relay local deadman back up to remote
    #def relay_deadman(buttons):
    #    if (buttons.get('deadman', 1) == 0) and (joy.buttons.get('deadman', 0) == 1):
    #        print("zeroing joy deadman")
    #        joy._report_button('deadman', 0)

    #c.on('joy', 'buttons', relay_deadman)
    c.joy = joy
    #joy.on(
    #    'buttons',
    #    lambda d: c.no_return_call('joy.trigger', 'buttons', d))
    #joy.on(
    #    'axes',
    #    lambda d: c.no_return_call('joy.trigger', 'axes', d))
    run_ui(ui)


if __name__ == "__main__":
    ui = load_ui()
    run_ui(ui)
