braingram/stompy/(commit log)

2016-06-17 cleaning up leg kinematics
2016-06-26 pushing before switching to velocity control
2016-07-04 adding trace_leg_closed_loop test script
2016-07-04 switch serial messages to degrees
2016-07-10 adding trajectory leg movement test
2016-07-16 adding cycle leg test and updated stand
2016-07-17 renaming calf joint to knee
2016-07-24 readding body moves and leg lifts to stand_trajectory test
2016-08-14 switching joint updates to callbacks, adding clock watching, separating joints and legs
2016-08-20 renaming joints
2016-08-20 adding some test code for a ros leg
2016-08-21 started leg code
2016-08-21 integrating heartbeat callback and teensy + ros heartbeats
2016-08-23 testing leg node heartbeat and joint publishing
2016-08-23 updating leg firmware
2016-08-27 adding time sync example so leg node can keep track of teensy time
2016-08-28 adding clock offset measurement to leg node
2016-08-28 testing leg node time sync
2016-09-05 state machine test, adding position leg to load
2016-09-07 filling out state machine, adding per-joint control, making less jerky, adding position legs and stand
2016-09-11 working on test state_machine2 with planner per leg
2016-09-17 firmware: adding joint angle conversions
2016-09-18 firmware to do servo tests
2016-09-20 rewrite of joint sensor conversion, writing bag publisher that restamps times
2016-10-23 adding on stompy sensor and valve tests
2016-10-27 adding simple leg script
2016-10-30 direct drive firmware, enabling motors
2016-11-09 updating direct drive firmware for current feedback
2016-11-10 fixing current feedback readings
2016-11-13 updating direct drive firmware for system voltage monitoring
2017-01-22 adding pump info
2017-01-25 Adding cylinder specs
2017-02-05 add imu info
2018-02-03 cleaning up tests and docs
    [ankle.stl, body.stl, calf_link.stl, calf_lower.stl, calf_upper.stl, foot.stl, hip.stl, thigh.stl]
2018-02-03 adding leg/body drawings
2018-02-03 start of teensy class
2018-02-03 tested teensy class
2018-02-04 adding calibration script
2018-02-08 simple single leg controller with joystick
2018-02-08 single_leg: speed and frame control
2018-02-10 adding fl calibration, reducing some speeds, tested on leg
2018-02-10 increase p and i for fr leg, now actually logging pid error
    [calibration.py, teensy.py]
2018-02-11 fixed mode switching
2018-02-11 report adc values
2018-02-11 a bit of tuning for the fake led pids
2018-02-11 fixing pwm value report
    [teensy.py]
2018-02-18 work on leg ui
2018-02-23 3d leg display test
2018-02-23 slightly decrease default foot coord velocity
2018-02-26 integrating single leg controller with qt ui
2018-03-15 fake legs starting to take shape
2018-03-17 faking calf load, testing with 3 legs up
2018-03-18 joystick working with multileg controller, mode switching working
2018-03-19 for testing start all legs in stance when entering res mode
2018-03-20 testing with <6 legs
2018-04-11 when connecting to 1 leg, don't compute neighbors
2018-04-11 splitting logs per leg
2018-04-15 adc sensor limit checking and leg direct pwm mode from joystick working
2018-04-18 adding start of calibration routine framework
2018-04-19 initial leg sensor limit calibration routine
2018-04-22 updating log file reading for multi-leg logs, added function to get adc min/max
2018-04-22 arc moves integrated through to body frame
2018-04-22 more leg calibrations
2018-04-29 adjusting calibrations using sensor units per inch, updating hip geometry
2018-05-02 tested joystick throttle
2018-05-06 reverting joystick throttle, didn't work on robot
2018-05-12 add function to compute calf angle relative to ground
2018-05-13 adding function to generate calf calibrations
2018-05-13 leg 2 calibration
2018-05-15 adding leg thing board kicad files
    [leg_thing.kicad_pcb, leg_thing.sch]
2018-05-17 minor bug when switching to restriction mode
    [restriction.py]
2018-05-17 add exception tracebacks to leg logs, optionally stop updates on exception
2018-05-20 reducing angular speed, setting max feet up to 1
    [leg_thing.kicad_pcb]
2018-05-22 fixed esp32thingpowershield footprint, started new layout
    [leg_thing.kicad_pcb]
2018-05-22 adding old alternative leg_thing board layout
    [leg_thing_alt.kicad_pcb]
2018-05-23 electronics: switching to 6 pin molex connectors
    [leg_thing.kicad_pcb, leg_thing.sch]
2018-05-24 electronics: finished layout with 6 pin molex
    [leg_thing.kicad_pcb]
2018-05-24 electronics: updating sch and pcb pdfs
2018-05-26 testing different pid seed times
2018-05-27 adding pull-up resistor on disable line
    [leg_thing.kicad_pcb, leg_thing.sch, leg_thing_alt.kicad_pcb]
2018-05-27 ui: attached seed time ui widgets
2018-05-27 adding updated calf calibration
2018-05-28 ui: adding following error threshold control, restriction: added loaded leg threshold
    [base.py, restriction.py, teensy.py]
2018-05-28 res: changing lower to allow for more slop
    [restriction.py]
2018-05-30 res: bringing out height slop as a parameter
    [restriction.py]
2018-06-12 switching restriction to use joint limits
2018-06-13 fixed velocity plan sending
    [plans.py]
2018-06-19 pulling leg res params into main cfg
2018-06-20 putting more res cfg into ui, moving legs by last lift time
2018-06-20 changing estop propagation to avoid infinite loops
    [consts.py, teensy.py]
2018-06-24 adjusting range of following error threshold ui
    [base.py]
2018-06-30 fixing x with vertical calf, adding x at calf angle
    [foot_falls.py]
2018-07-03 updating leg thing pdfs
2018-07-12 minor format change for rpm sensor
2018-09-09 fixing res halt, adding loop stats reporting
    [restriction.py, teensy.py, utils.py]
2018-09-26 updating log plot_key to ignore imu
2018-10-04 start of calibration/diagnostic script
2018-10-04 adding extra estop in case of keyboard interrupt
2018-10-05 adding print_joystick.py test
2018-10-15 starting dynamic remap of ps3 code-to-button map
2018-10-15 remapping ps3 joystick buttons to not need pressure sensing on shoulder buttons
2018-10-15 adding relative axes to print_joystick
2018-10-17 in the middle of swapping out widgets for non-opengl versions
    [base.py, nogl.py, ps3.py]
2018-10-18 pid plot nogl working, switch leg and body displays to right hand coords
2018-10-21 limit nogl paints to 10 hz
2018-10-21 fixed bug when lower starts below lower height
    [restriction.py]
2018-10-21 reset restriction halt state on enable
    [restriction.py]
2018-10-27 reset delta-res calc on leg mode change
    [restriction.py]
2018-10-27 ui bug: res.cfg.speeds.angular not editable
    [base.py]
2018-10-28 slowing down all pids to 50 hz
2018-10-28 setting dither for all joints
2018-11-12 updating leg 1 and 2 calibrations
2018-11-12 log find adc limits now returns values
2018-11-12 updating leg string pot calibrations
2018-11-18 fix limit calc to use limited hip length for non-middle legs
2018-11-18 refactor: pull restriction out of leg submodule, split into cfg, leg, body
2018-11-25 updating calf calibrations
2018-12-02 fixing omni x axis
2018-12-29 adjusting pid values
2018-12-30 set plan_step from first connected leg
2019-01-10 fix missing PLAN_TICK for fake teensies
    [teensy.py]
2019-01-12 add debug print
2019-01-13 leg 4 calf recal after sensor wiring work
2019-01-13 make test teensy leg
2019-01-15 fix ui leg selection, change io polling time, change fake leg pid
    [calibration.py, ps3.py, ui.py]
2019-01-17 add selected leg highlighting
2019-02-09 adding sensor noise to fake leg
    [teensy.py]
2019-02-09 add log to res control, fix res unhalt
    [body.py]
2019-02-17 add calibration menu, save/load cal in home directory, online calf zero point setting
2019-02-17 adding calibrations from calibration.py
2019-02-17 fixed saved calf cal format
    [teensy.py]
2019-02-17 correct calf calibration mgr calls
    [calibration.py]
2019-02-17 calibration: zeroed front right calf
2019-02-23 adding restrict_leg button support to ps3
2019-02-23 adding buttons to steel joystick
2019-02-23 test script to plot leg res
2019-02-24 on connection to leg teensy, toggle rts to reset communications
    [teensy.py]
2019-02-25 added settings: prevent_leg_xy_when_loaded, set_height_on_mode_select
    [base.py]
2019-02-25 testing reset com on connect, legs look better, body computer worse
    [__main__.py, body.py, utils.py]
2019-03-17 reorg of parameters into Param class, started switch to more compact ui
2019-03-23 remote: combine get and getitem (same for set) allow for brackets in names
2019-04-07 fix sizing of leg display
    [base.py]
2019-04-09 switching to remote ui as default
2019-04-10 getting pid config working again in remote display
2019-04-25 pull multileg.py out of controllers, rename to controller.py, make odometer only record points after some fixed distance
    [__main__.py, controller.py, teensy.py, ui.py]
2019-05-27 fixed bug when setting override_min_hip_distance
    [body.py, controller.py, playback.py]
2019-06-08 wip backend support triangle calc, log py3 fixes, starting unification of kinematics
    [controller.py, log.py]
2019-06-09 reorg kinematics to allow per-leg geometry
2019-06-15 bringing mode and leg select out to ui radio buttons
2019-06-18 fixing bug where menu select of leg/mode didn't update radio buttons
    [joystick.py, ui.py]
2019-06-19 updaing ui to use imu
2019-06-22 Adding (rough) spine weight from CAD/gazebo
2019-06-22 fixing support triangle calc, adding statics.Stance for static calcs
    [controller.py, statics.py, ui.py]
2019-06-22 removed print
2019-07-06 faking imu readings for cog calcs, verified directions
2019-07-21 fix support leg ui drawing, add height measurement to non-walk modes
    [base.py, controller.py, nogl.py, statics.py]
2019-07-25 adding disable_joystick parameter, fixing remote stop
    [controller.py]
2019-07-25 joystick: require circle down before mode or leg select
2019-07-28 some ui fixes, display restriction as text
    [nogl.py, ui.py]
2019-07-28 fixing dialog for negative values, display restriction 'center' positions
    [nogl.py, ui.py]
2019-07-30 adding spot for and first stab at body calibration
2019-08-01 shiftable leg centers, use projected restriction, fixing halt/unhalt bug, adding halt and res states to ui
    [body.py, nogl.py, plans.py, teensy.py, ui.py]
2019-08-01 update requirements.txt for only pyqt5, remove extra print
2019-08-05 adding bullet physics sim with (too) floppy ankles
    [ankle.stl, body.stl, calf_link.stl, calf_lower.stl, calf_upper.stl, dollies.urdf, foot.stl, hip.stl]
2019-08-06 calf load and imu (needs verification) working in sim
    [stompy.urdf]
2019-08-06 fixing simulated imu pitch direction
    [controller.py]
2019-09-14 changes to restriction calculation, tuning simulation
    [plane.urdf]
2019-09-14 compute ground slope using imu and leg positions
2019-09-28 adding mode for moving front legs together
2019-11-10 fix ui value bounds, disable front pair mode, changes to leg wiggle playback
    [controller.py, playback.py]
2019-11-24 swap points for cross product to keep z positive
    [statics.py]
2019-12-17 add param for autoheight thresh, leg center shift thresholds
2019-12-31 switching calibration save format to json
2020-01-26 relaying halt signal from res body to legs, if res modifier is non 0 = should lift
2020-01-27 adding annotations, no fix for nr calc gating
    [body.py]
2020-02-02 moving some code from restriction/leg to kinematics/leg
2020-02-02 switching functions from numpy to math
2020-02-02 reorg how halt/unhalt happens and how leg plans are sent
2020-02-04 increase leg speed if running in nosim sim
2020-03-08 adding serial for new box 4 teensy
